fatooo/PITECH/Poster/2-IMG_20190511_161719.png

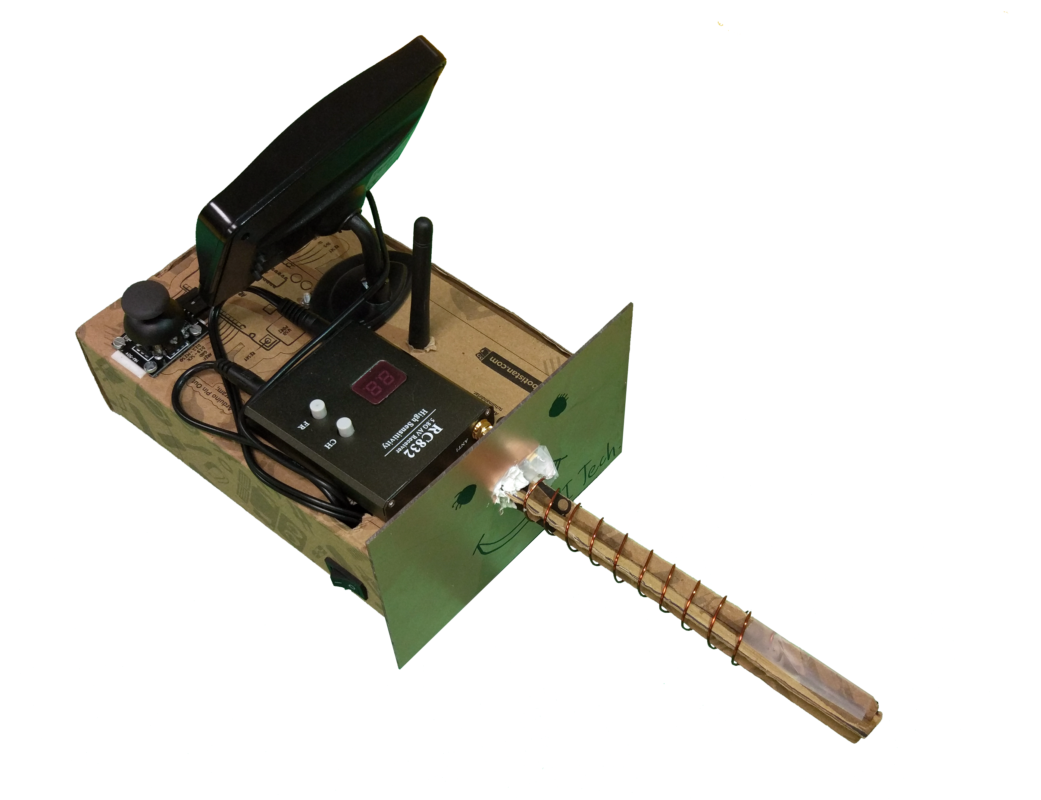
Poster/2-IMG_20190511_161719.png
