fatooo/PITECH/Weeklyler/weekly-12/Ekran Alıntısı3.PNG

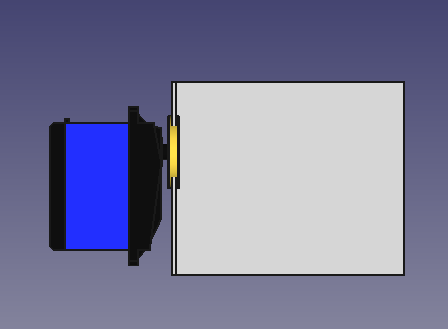
Weeklyler/weekly-12/Ekran Alıntısı3.PNG
