fatooo/PITECH/Final Report/schematic.docx

Appendix II

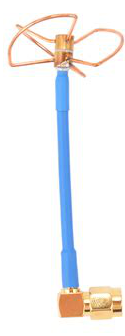
[picture p4: figure]
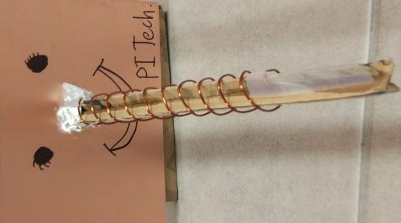
[picture p5: figure]

Overall Circuit Schematic

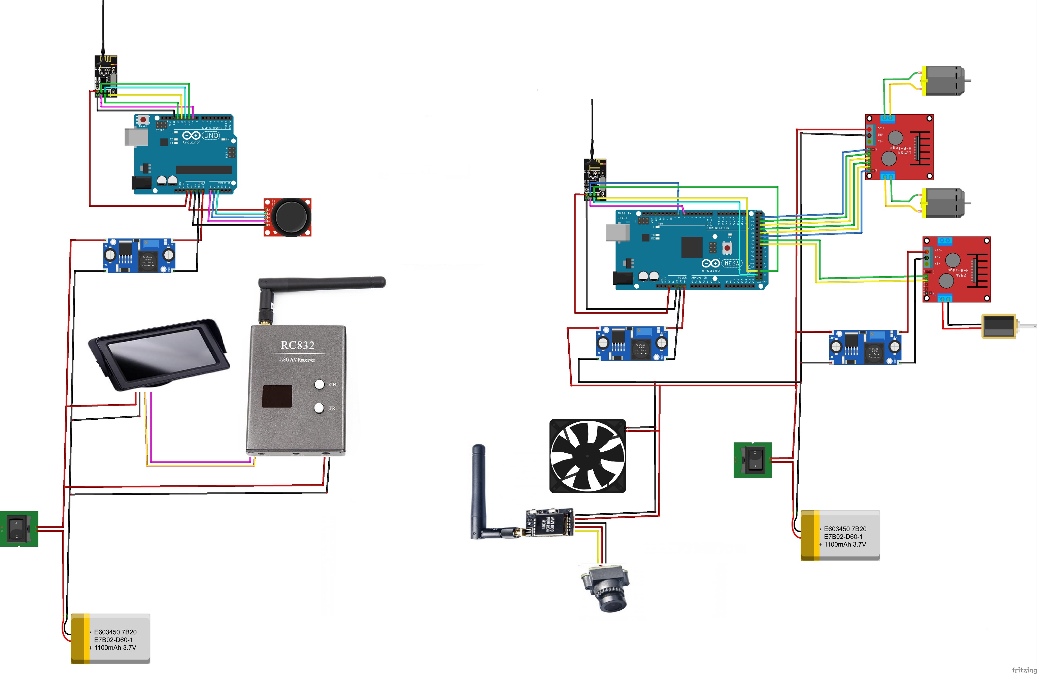
[picture p6: figure]
