fatooo/PITECH/Critical Report/headers.docx

# 1. Executive Summary

# 2. Introduction

# 3. Overall System Description

## 3.1. General Description

## 3.2. Individual Description

### 3.2.1. Power Supply Subsystem

#### 3.2.1.1. Solution Approach

#### 3.2.1.2. Block Diagram & Flowchart

### 3.2.2. Telecommunication Subsystem

#### 3.2.2.1. Solution Approach

#### 3.2.2.2. Block Diagram & Flowchart

### 3.2.3. Shooting Subsystem

#### 3.2.3.1. Solution Approach

#### 3.2.3.2. Block Diagram & Flowchart

### 3.2.4. Motion Subsystem

#### 3.2.4.1. Solution Approach

#### 3.2.4.2. Block Diagram & Flowchart

### 3.2.5. Detection Subsystem

#### 3.2.5.1. Solution Approach

#### 3.2.5.2. Block Diagram & Flowchart

## 3.3. System Level Block Diagram

## 3.4. 3D Drawings

# 4. Requirements

# 5. Design Modifications

# 6. Compatibility of the Subsystems

# 7. Test Procedures

## 7.1. Power Supply Subsystem

## 7.2. Telecommunication Subsystem

## 7.3. Shooting Subsystem

## 7.4. Motion Subsystem

## 7.5. Detection Subsystem

# 8. Compliance

# 9. Resource Management

## 9.1. Cost Estimation Breakdown

## 9.2. Power Management

## 9.3. Gantt Chart
