fatooo/PITECH/Conceptual Presentation/CONCEPTUAL_BerkayPArt.pptx

## CONCEPTUAL DESIGN PRESENTATION Devices Trying to Score in Each Others’ Goals

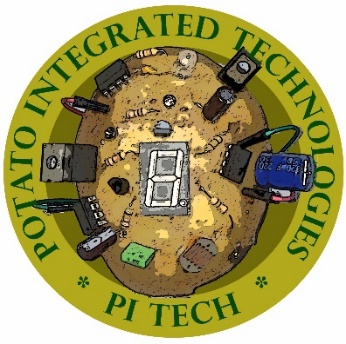
[picture p46: figure]
A close up of a clock Description generated with high confidence

PITECH

## CEO FATMA NUR ARABACI

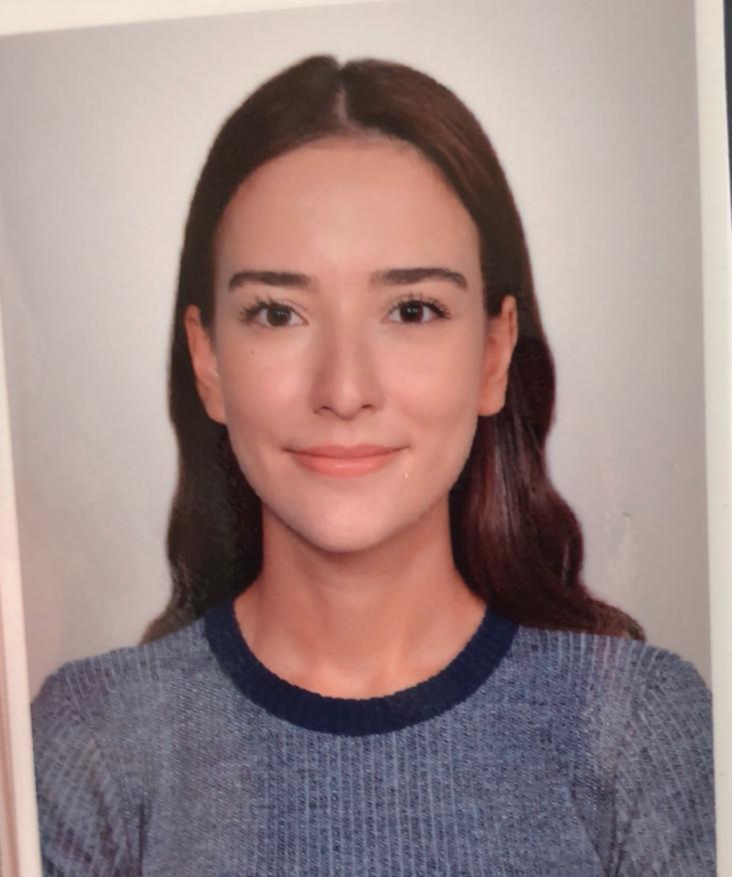
[picture p47: figure]

PITECH

## Presentation Outline

Company Profile

Problem Statement

Requirements & Objectives

01

04

Solution Approaches

Plans

02

05

03

06

Conclusion

PITECH

## COMPANY PROFILE Shareholders

- FATOOOO GELCEK

COO İrem COŞKUN 2030419 | CMO Berkay GÖKSU 2030757 | CTO Furkan Bahadır ELİK 2030518 | CEO Fatma Nur ARABACI 2030047 | CFO Aycan BEYENİR 2030328

PITECH

## Slide 5

Mission
To provide creative and reliable solutions that fulfill the needs of industry in the field of Industrial robot applications.
Vision
To become the most compelling technology company by driving the Industry’s transition to smart manufacturing.

COMPANY PROFILE
Mission & Vision

PITECH

## PROBLEM STATEMENT

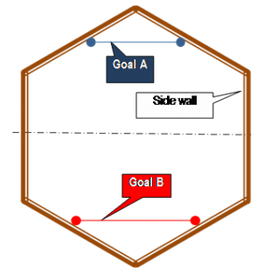
[picture p48: figure]

- Try to score in the opponents’ goal
- Try to defend our own goal
- Control via tele-controller (non-autonomous)

75 cm

PITECH

## Slide 7

Oppenents’ Goal

Opponents’ Robot

Playfield Side

The ball

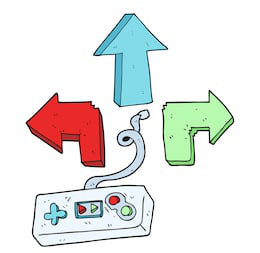
[picture p49: figure]
controller cartoon ile ilgili gÃ¶rsel sonucu

Controller Side

Half Field Line

Our Goal

> 30 m

Our Robot

PITECH

## REQUIREMENTS & OBJECTIVES Requirements & Constraints

Oppenents’ Goal

- Goal line should be two times of our robots’ diameter
- 20 sec Restriction
- Robot should stay in its’ half field
- Carrying, grasping and scooping the ball is not allowed.
- Within $200 budget

Half Field Line

Our Goal

PITECH

## REQUIREMENTS & OBJECTIVES Performance Related Objectives

Range

- Perfect–>more than 30m
- Sufficient-> 30 m indoor
- Poor/Failure-> less than 30 m

Power Consumption

- Perfect–> 30 min of operation
- Sufficient -> 15 min of operation
- Poor -> 5 min of operation

Transmission Delay

- Perfect–> 100 ms delay
- Good -> 400 ms delay
- Sufficient-> 600 ms delay
- Poor-> 1 sec delay

PITECH

## CMO BERKAY GÖKSU

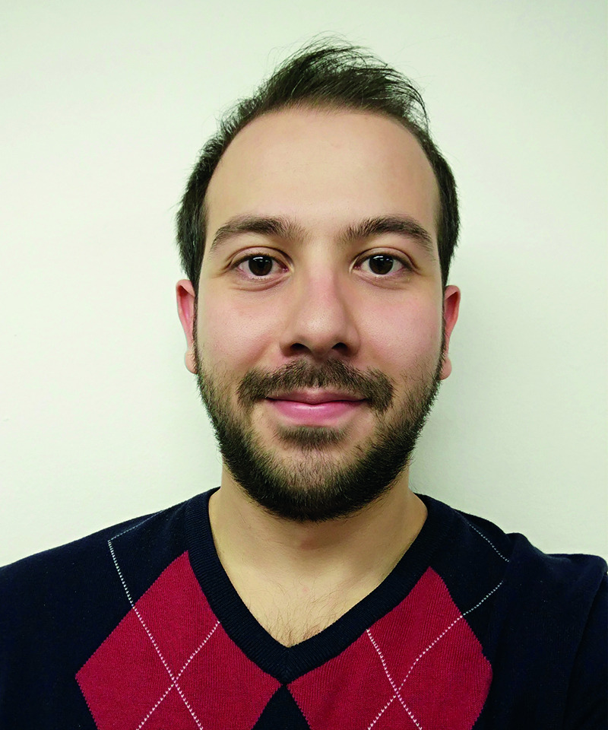
[picture p50: figure]

PITECH

## Overall Block Diagram Flow Chart Shooting Subsystem Motion Subsystem

PITECH

## Block Diagram of Robot Side

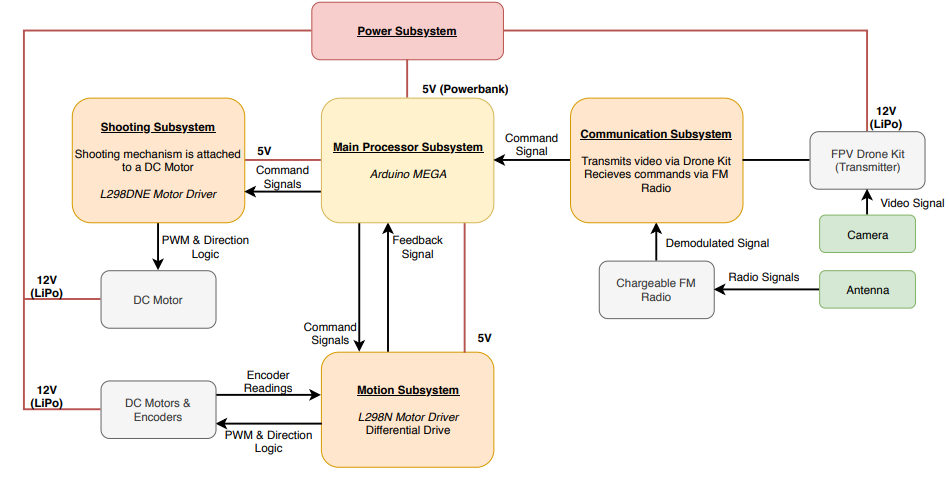
[picture p51: figure]

PITECH

## Block Diagram of Controller Side

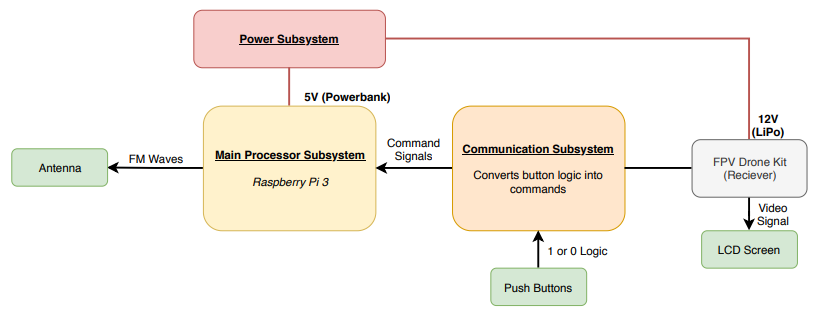
[picture p52: figure]

PITECH

## Flow Chart

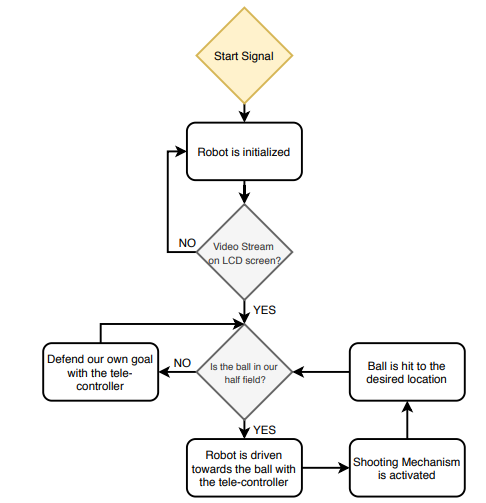
[picture p53: figure]

PITECH

## Subsystems

Shooting Subsystem
Motion Subsystem
Communication Subsystem
Power Supply Subsystem
Main Processor Subsystem

PITECH

## Shooting Subsystem

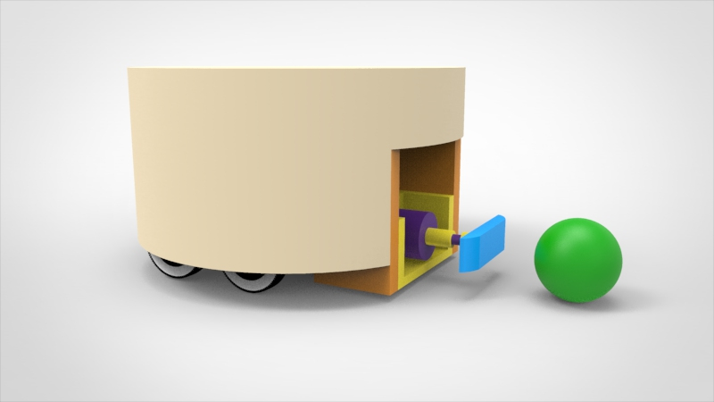
[picture p54: figure]
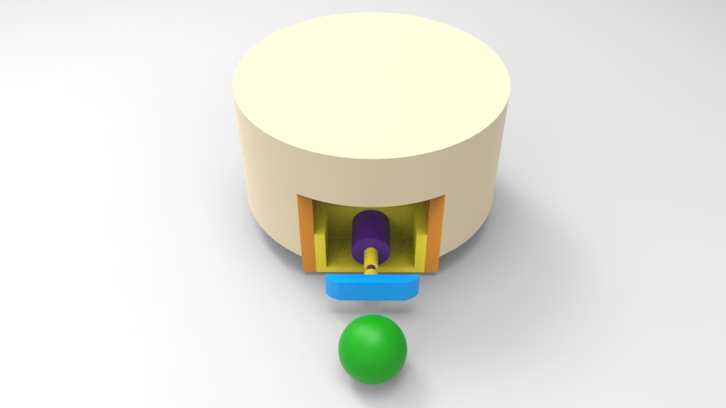
[picture p55: figure]

PITECH

## Slide 17

- Spring actuated
- Very powerful, much energy can be stored
- Simple mechanism (wound up, held, and released)

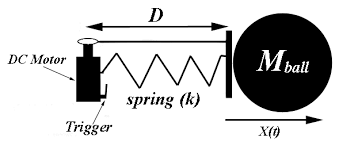
[picture p56: figure]

PITECH

## Motion Subsystem

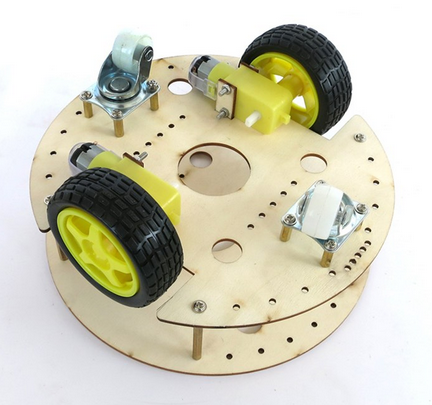
[picture p57: figure]
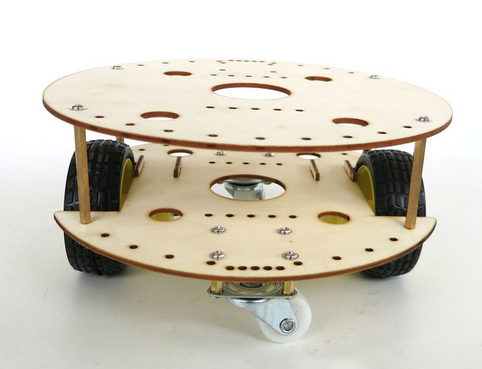
[picture p58: figure]

2 DC Motors and encoders & 2 Drive Wheels
2 Caster Wheels

PITECH

## Differential Drive

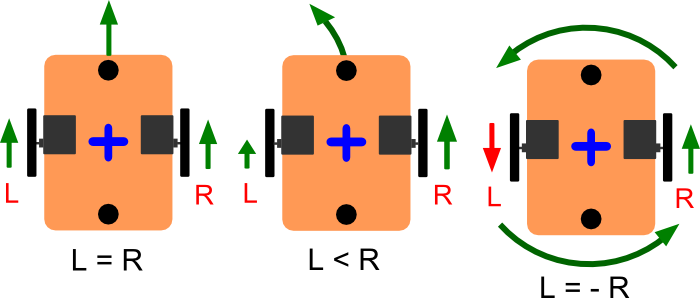
[picture p59: figure]
differential drive kinematics ile ilgili görsel sonucu

- Easy to program
- Well controlled
- Simple
- Low Cost

PITECH

## CTO FURKAN BAHADIR ELİK

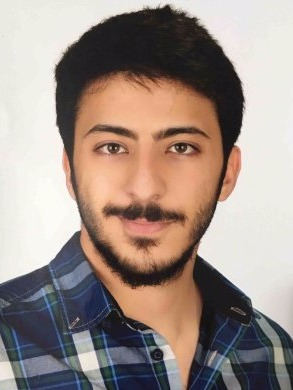
[picture p60: figure]

PITECH

## Slide 21

PITECH

## Slide 22

PITECH

## Slide 23

PITECH

## Slide 24

PITECH

## Slide 25

PITECH

## Slide 26

PITECH

## Slide 27

PITECH

## CFO AYCAN BEYENİR

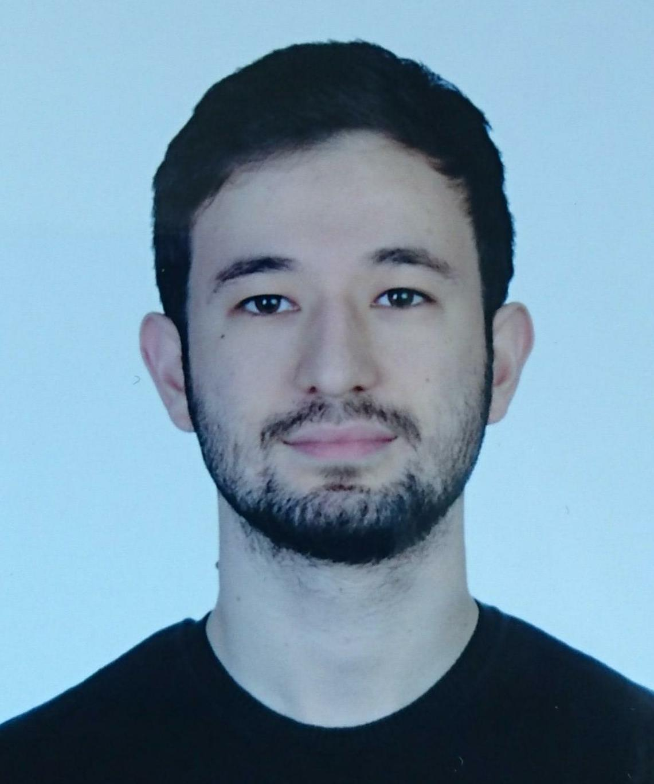
[picture p61: figure]

PITECH

## Slide 29

PITECH

## Slide 30

PITECH

## Slide 31

PITECH

## Slide 32

PITECH

## Slide 33

PITECH

## Slide 34

PITECH

## Slide 35

PITECH

## COO İREM COŞKUN

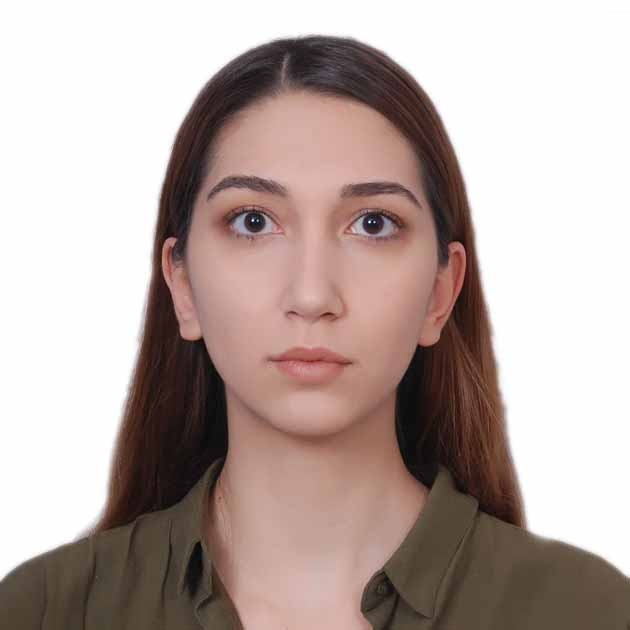
[picture p62: figure]

PITECH

## Slide 37

PITECH

## Slide 38

PITECH

## Slide 39

PITECH

## Slide 40

PITECH

## Slide 41

PITECH

## Slide 42

PITECH

## Slide 43

PITECH
