fatooo/PITECH/Conceptual Presentation/Creative-Idea-Bulb-PowerPoint-Template.pptx

- FREE
- PPT TEMPLATES

- INSERT THE TITLE
- OF YOUR PRESENTATION HERE

LogoType

http://www.free-powerpoint-templates-design.com

## Slide 2

Agenda Style

Add Contents Title

You can simply impress your audience and add a unique zing.

01

02

Add Contents Title

You can simply impress your audience and add a unique zing.

03

Add Contents Title

You can simply impress your audience and add a unique zing.

04

Add Contents Title

You can simply impress your audience and add a unique zing.

## Slide 3

- Section Break

- Insert the title of your subtitle Here

## Slide 4

- Welcome!!

- Insert the title of your subtitle Here

“

Easy to change colors, photos and Text. Get a modern PowerPoint Presentation that is beautifully designed. I hope and I believe that this Template will your Time, Money and Reputation. Easy to change colors, photos and Text. Easy to change colors, photos and Text. Get a modern PowerPoint Presentation that is beautifully designed.

“

Your Text Here

Contents

## Slide 5

- Our Services

- Insert the title of your subtitle Here

01

Your Text Here

You can simply impress your audience and add a unique zing and appeal to your Presentations.

Your Text Here

You can simply impress your audience and add a unique zing and appeal to your Presentations.

04

Your Text Here

You can simply impress your audience and add a unique zing and appeal to your Presentations.

Your Text Here

You can simply impress your audience and add a unique zing and appeal to your Presentations.

02

05

03

Your Text Here

You can simply impress your audience and add a unique zing and appeal to your Presentations.

06

Your Text Here

You can simply impress your audience and add a unique zing and appeal to your Presentations.

## Slide 6

- Our Team Layout

- Insert the title of your subtitle Here

Name Here

Programmer

You can simply impress your audience and add a unique zing.

Name Here

Programmer

You can simply impress your audience and add a unique zing.

Name Here

Programmer

You can simply impress your audience and add a unique zing.

Name Here

Programmer

You can simply impress your audience and add a unique zing.

## Slide 7

- Timeline Style

- Insert the title of your subtitle Here

You can simply impress your audience and add a unique zing and appeal to your Presentations.

2016

You can simply impress your audience and add a unique zing and appeal to your Presentations.

2018

2015

You can simply impress your audience and add a unique zing and appeal to your Presentations.

2017

You can simply impress your audience and add a unique zing and appeal to your Presentations.

2019

You can simply impress your audience and add a unique zing and appeal to your Presentations.

## Slide 8

- Infographic Style

- Insert the title of your subtitle Here

Add Contents Title

Easy to change colors, photos and Text.

Add Contents Title

Easy to change colors, photos and Text.

Add Contents Title

Add Contents Title

Easy to change colors, photos and Text.

Add Contents Title

Easy to change colors, photos and Text.

Add Contents Title

Easy to change colors, photos and Text.

Easy to change colors, photos and Text.

## Slide 9

- Infographic Style

- Insert the title of your subtitle Here

01

02

03

04

05

Add Contents Title

Your Text Here

You can simply impress your audience and add a unique zing and appeal to your Presentations.

Add Contents Title

Add Contents Title

Add Contents Title

Add Contents Title

## Slide 10

Portfolio
Presentation
Designed

Get a modern PowerPoint Presentation that is beautifully designed. Easy to change colors, photos and Text. You can simply impress your audience and add a unique zing and appeal to your Presentations. Get a modern PowerPoint Presentation that is beautifully designed. Easy to change colors, photos and Text. Get a modern PowerPoint Presentation that is beautifully designed.

## Slide 11

- Infographic Style

- Insert the title of your subtitle Here

Your Text Here

You can simply impress your audience and add a unique zing.

Your Text Here

You can simply impress your audience and add a unique zing.

Your Text Here

You can simply impress your audience and add a unique zing.

Your Text Here

You can simply impress your audience and add a unique zing.

Your Text Here

You can simply impress your audience and add a unique zing.

Your Text Here

You can simply impress your audience and add a unique zing.

Your Text Here

You can simply impress your audience and add a unique zing.

Your Text Here

You can simply impress your audience and add a unique zing.

## Slide 12

- Infographic Style

- Insert the title of your subtitle Here

You can simply impress your audience and add a unique zing and appeal to your Presentations.

Your Text Here

Your Text Here

You can simply impress your audience and add a unique zing and appeal to your Presentations.

## Slide 13

- NetBook Style

- Insert the title of your subtitle Here

Easy to change colors, photos and Text. You can simply impress your audience and add a unique zing and appeal to your Presentations. You can simply impress your audience and add a unique zing and appeal to your Presentations.
You can simply impress your audience and add a unique zing and appeal to your Presentations.

Text Here

You can simply impress your audience and add a unique zing and appeal to your Presentations. Easy to change colors, photos and Text.

## Slide 14

- Infographic Style

- Insert the title of your subtitle Here

Your Text Here

You can simply impress your audience and add a unique zing and appeal to your Presentations.

Your Text Here

You can simply impress your audience and add a unique zing and appeal to your Presentations.

Your Text Here

You can simply impress your audience and add a unique zing and appeal to your Presentations.

Your Text Here

You can simply impress your audience and add a unique zing and appeal to your Presentations.

Your Text Here

You can simply impress your audience and add a unique zing and appeal to your Presentations.

## Slide 15

- Portfolio Presentation

- Insert the title of your subtitle Here

Simple Portfolio Designed

Get a modern PowerPoint Presentation that is beautifully designed. Easy to change colors, photos and Text. You can simply impress your audience and add a unique zing and appeal to your Presentations. Get a modern PowerPoint Presentation that is beautifully designed. Easy to change colors, photos and Text. Get a modern PowerPoint Presentation that is beautifully designed.

## Slide 16

- Infographic Style

- Insert the title of your subtitle Here

Your Text Here

You can simply impress your audience and add a unique zing and appeal to your Presentations.

Your Text Here

You can simply impress your audience and add a unique zing and appeal to your Presentations.

A

B

D

C

Your Text Here

You can simply impress your audience and add a unique zing and appeal to your Presentations.

Your Text Here

You can simply impress your audience and add a unique zing and appeal to your Presentations.

## Slide 17

Your Text Here

Simple Portfolio
Designed

Get a modern PowerPoint Presentation that is beautifully designed. Easy to change colors, photos and Text. You can simply impress your audience and add a unique zing and appeal to your Presentations. Get a modern PowerPoint Presentation that is beautifully designed. Easy to change colors, photos and Text. Get a modern PowerPoint Presentation that is beautifully designed.

Your Text Here

Your Text Here

Your Text Here

## Slide 18

- Chart Style

- Insert the title of your subtitle Here

80%

Add Contents Title

You can simply impress your audience and add a unique zing.

80%

50%

You can simply impress your audience and add a unique zing and appeal to your Presentations. Get a modern PowerPoint Presentation that is beautifully designed. You can simply impress your audience and add a unique zing and appeal to your Presentations. Get a modern PowerPoint Presentation that is beautifully designed.
Get a modern PowerPoint Presentation that is beautifully designed. Easy to change colors, photos and Text.

40%

70%

60%

## Slide 19

PowerPoint Presentation

- Worldmap Style

You can simply impress your audience and add a unique zing and appeal to your Presentations. Easy to change colors, photos and Text. Easy to change colors, photos and Text. Get a modern PowerPoint Presentation that is beautifully designed. Easy to change colors, photos and Text.
Get a modern PowerPoint Presentation that is beautifully designed. You can simply impress your audience and add a unique zing and appeal to your Presentations. Easy to change colors, photos and Text.

## Slide 20

Portfolio Designed

You can simply impress your audience and add a unique zing and appeal to your Presentations.

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

Portfolio
Presentation
Designed

## Slide 21

- Infographic Style

- Insert the title of your subtitle Here

Your Text Here

Easy to change colors, photos and Text.

Infographic Designed

Easy to change colors, photos and Text.

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

Your Text Here

Easy to change colors, photos and Text.

Your Text Here

Easy to change colors, photos and Text.

Your Text Here

Easy to change colors, photos and Text.

## Slide 22

- Table Style

- Insert the title of your subtitle Here

Your Text Here
$52
| Text Here
| You can simply impress your audience and add a unique zing.
Your Text Here

Your Text Here
$80
| Text Here
| You can simply impress your audience and add a unique zing.
Your Text Here

Your Text Here
$75
| Text Here
| You can simply impress your audience and add a unique zing.
Your Text Here

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

## Slide 23

- Mobile Style

- Insert the title of your subtitle Here

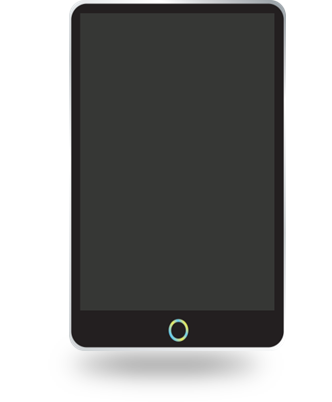
[picture p101: figure]

Simple Portfolio Designed

Your Text Here

You can simply impress your audience and add a unique zing and appeal to your Presentations.

Your Text Here

You can simply impress your audience and add a unique zing and appeal to your Presentations.

Your Text Here

You can simply impress your audience and add a unique zing and appeal to your Presentations.

Your Text Here

Easy to change colors, photos and Text.

Your Text Here

Easy to change colors, photos and Text.

Your Text Here

Easy to change colors, photos and Text.

## Slide 24

- Chart Style

- Insert the title of your subtitle Here

40%

Your Text Here

Get a modern PowerPoint Presentation that is beautifully designed.

Your Text Here

Get a modern PowerPoint Presentation that is beautifully designed.

35%

## Slide 25

- Portfolio Presentation

- Insert the title of your subtitle Here

You can simply impress your audience and add a unique zing and appeal to your Presentations. Easy to change colors, photos and Text.

## Slide 26

- Infographic Style

- Insert the title of your subtitle Here

01

Your Text Here

You can simply impress your audience and add a unique zing and appeal to your Presentations.

Your Text Here

You can simply impress your audience and add a unique zing and appeal to your Presentations.

Your Text Here

You can simply impress your audience and add a unique zing and appeal to your Presentations.

Your Text Here

You can simply impress your audience and add a unique zing and appeal to your Presentations.

02

03

04

## Slide 27

- Chart Style

- Insert the title of your subtitle Here

Your Text Here

You can simply impress your audience and add a unique zing and appeal to your Presentations.

Your Text Here

You can simply impress your audience and add a unique zing and appeal to your Presentations.

Your Text Here

You can simply impress your audience and add a unique zing and appeal to your Presentations.

50%

70%

30%

## Slide 28

- Worldmap Style

- Insert the title of your subtitle Here

Your Text Here

Simple PowerPoint
Presentation Designed

Get a modern PowerPoint Presentation that is beautifully designed. You can simply impress your audience and add a unique zing and appeal to your Presentations.

Text Here

You can simply impress your audience and add a unique zing.

Text Here

You can simply impress your audience and add a unique zing.

Text Here

You can simply impress your audience and add a unique zing.

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

## Slide 29

Portfolio
Presentation
Designed

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

## Slide 30

- Table Style

- Insert the title of your subtitle Here

PowerPoint Presentation

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

Your Text Here

| $150
| Content Here
| Text Here
| Text Here
| Text Here
| Text Here
| Text Here
Content Here

| $180
| Content Here
| Text Here
| Text Here
| Text Here
| Text Here
| Text Here
Content Here

| $160
| Content Here
| Text Here
| Text Here
| Text Here
| Text Here
| Text Here
Content Here

## Slide 31

Your Text Here

You can simply impress your audience and add a unique zing and appeal to your Presentations. Easy to change colors, photos and Text.
You can simply impress your audience and add a unique zing and appeal to your Presentations. You can simply impress your audience and add a unique zing and appeal to your Presentations. Easy to change colors, photos and Text. You can simply impress your audience and add a unique zing and appeal to your Presentations. You can simply impress your audience and add a unique zing and appeal to your Presentations. Easy to change colors, photos and Text. You can simply impress your audience and add a unique zing and appeal to your Presentations.
You can simply impress your audience and add a unique zing and appeal to your Presentations.
Easy to change colors, photos and Text. You can simply impress your audience and add a unique zing and appeal to your Presentations. You can simply impress your audience and add a unique zing and appeal to your Presentations.

One Columns Designed

## Slide 32

Two Columns Designed

Your Text Here

You can simply impress your audience and add a unique zing and appeal to your Presentations. Easy to change colors, photos and Text.
You can simply impress your audience and add a unique zing and appeal to your Presentations. You can simply impress your audience and add a unique zing and appeal to your Presentations. Easy to change colors, photos and Text. You can simply impress your audience and add a unique zing and appeal to your Presentations.
You can simply impress your audience and add a unique zing and appeal to your Presentations.

Your Text Here

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

## Slide 33

- Thank you

- Insert the title of your subtitle Here

## Slide 34

- Fully Editable Shapes

## Slide 35

- Fully Editable Icon Sets : A

You can Resize without losing quality

You can Change Fill Color &
Line Color

FREE
PPT TEMPLATES

www.allppt.com

## Slide 36

- Fully Editable Icon Sets : B

You can Resize without losing quality

You can Change Fill Color &
Line Color

FREE
PPT TEMPLATES

www.allppt.com

## Slide 37

- Fully Editable Icon Sets : C

You can Resize without losing quality

You can Change Fill Color &
Line Color

FREE
PPT TEMPLATES

www.allppt.com
