fatooo/PITECH/Weeklyler/Weekly 16.docx

20.03.2019-26.03.2019

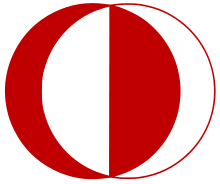
[picture p103: figure]
Image result for METU

MIDDLE EAST TECHNICAL UNIVERSITY

DEPARTMENT OF ELECTRICAL AND ELECTRONICS ENGINEERING

EE493 – Weekly Progress Report #16

POTATO INTEGRATED TECHNOLOGIES

A close up of a clock Description generated with high confidence

Design Studio Coordinator: Arzu KOÇ

Partners and Contact Information:

Fatma Nur ARABACI 2030047 0533 602 75 27 arabaci.fn@gmail.com

İrem COŞKUN 2030419 0539 414 59 69 iremcoskun0@gmail.com

Aycan BEYENİR 2030328 0539 330 05 70 abeyenir@gmail.com

Berkay GÖKSU 2030757 0505 635 81 45 berkaygoksu1@gmail.com

Furkan Bahadır ELİK 2030518 0554 963 94 10 elik.bahadir@metu.edu.tr

What has been done:

In this week we implemented our range test for the command system after receiving the delivery of the antenna. Even though we conducted the same test in design laboratory we couldn’t have obtained the desired outcomes. However, with this new antenna we managed to control our robot from the top floor of E-block when the robot is placed close to the canteen in D-block. We are planning to conduct the same test by connecting a bypass capacitor between the Vcc and GND pins of the transmitter side Arduino. We are expecting to see improved performance even though this current range is enough for the command part.

We also optimized our motor code so that it can achieve smooth start and brake. We also tuned it’s speed by considering the sizes of the playfield. Later touchups can be made in the future regarding our final product.

Furthermore, we also bought spacers for the physical structure of our robots’ chassis, step-up & down regulators, and 3s LiPo battery with 1350 mAh capacity to drive the DC motors. This one has a greater capacity so that we do not need to charge the batteries that often.

Next week’s plan:

- Second layer of the robot will be integrated with the first layer using the spacers
- Regulator tests will be done.
- Shooting subsystem will be tested with step-up regulator.
