fatooo/PITECH/Weeklyler/Weekly-10/Week-10.docx

13.12.2018-20.12.2018

Image result for METU

MIDDLE EAST TECHNICAL UNIVERSITY

DEPARTMENT OF ELECTRICAL AND ELECTRONICS ENGINEERING

EE493 – Weekly Progress Report #10

POTATO INTEGRATED TECHNOLOGIES

A close up of a clock Description generated with high confidence

Design Studio Coordinator: Arzu KOÇ

Partners and Contact Information:

Fatma Nur ARABACI 2030047 0533 602 75 27 arabaci.fn@gmail.com

İrem COŞKUN 2030419 0539 414 59 69 iremcoskun0@gmail.com

Aycan BEYENİR 2030328 0539 330 05 70 abeyenir@gmail.com

Berkay GÖKSU 2030757 0505 635 81 45 berkaygoksu1@gmail.com

Furkan Bahadır ELİK 2030518 0554 963 94 10 elik.bahadir@metu.edu.tr

What has been done:

In this week we put our full concentration on the preparations for demo. We worked mostly on optimizations of the subsystems. This week also we decided that out plans is going to be drone kit from now on for video transmission (detection subsystem).New test procedure has been written for new method and updated version submitted. Also, some visual improvements made for demonstration. Moreover, new equipment bought from Konya Sokak.

Optimization of the Command Transmission:

To improve the command transmission we changed our antenna. LED and button instalments made to different boxes. Final connections for demonstration made. Now, we have a fully functional system which blinks the LED when same colored button pressed. We worked on amplifier circuit. Amplifier circuit designs made but during the experiments it did not show as planned due to the reason that our transistor cannot drive high frequencies

Video Transmission:

We received our shipments for video transmission. We tried the systems and have better results than our image processing system so we decided to move with that for now on. Actually this was always a plan for us but since we haven’t received our shipments we did not have time to work on that. We worked on image processing because we have not received our shipment. We bought li-po battery for video transmitter and camera system. 3s li-po with 900 mAh selected. Also for, receiving video we bought screen to watch the video at the same time. Another li-po is also needed for video receiver but since we have not decided how to drive our motors we will work with power supply for demonstration.

Next week’s plan:

Next week we are planning to work on conceptual design and presentation. All the solutions for subsystems and whole module will be decided. Detailed time plan, solutions and test procedures will be argued. A weekly meeting will be held in company headquarters.
