fatooo/PITECH/raspberrypidenemeleri/image_process/image_process_detect_ball_Python.docx

import RPi.GPIO as GPIO

GPIO.setmode(GPIO.BOARD)

GPIO.setup(37, GPIO.OUT)

GPIO.setup(35, GPIO.OUT) # GPIO INITIALIZATION

GPIO.setup(33, GPIO.OUT)

GPIO.setup(29, GPIO.OUT)

GPIO.setup(31, GPIO.OUT)

GPIO.setup(38, GPIO.OUT)

GPIO.setup(40, GPIO.OUT)

GPIO.setup(7, GPIO.IN)

import math

center_read=325

center_read_green=320

# import the necessary packages

from picamera.array import PiRGBArray # CAMERA INITIALIZATION

from picamera import PiCamera

import time

import cv2

import numpy as np

# initialize the camera and grab a reference to the raw camera capture

camera = PiCamera()

camera.resolution = (640, 480)

camera.framerate = 50

camera.hflip = True

rawCapture = PiRGBArray(camera, size=(640, 480))

# allow the camera to warmup

time.sleep(0.1)

def find_red_center():

# capture frames from the camera

for frame in camera.capture_continuous(rawCapture, format="bgr", use_video_port=True):

# grab the raw NumPy array representing the image, then initialize the timestamp

# and occupied/unoccupied text

image = frame.array

blur = cv2.blur(image, (3,3))

#hsv to complicate things, or stick with BGR

hsv = cv2.cvtColor(blur,cv2.COLOR_BGR2HSV)

#thresh = cv2.inRange(hsv,np.array((0, 200, 200)), np.array((20, 255, 255)))

lower = np.array([167,184,86],dtype="uint8")

#upper = np.array([225,88,50], dtype="uint8")

upper = np.array([179,255,255], dtype="uint8")

thresh = cv2.inRange(hsv, lower, upper)

thresh2 = thresh.copy()

# find contours in the threshold image

contours,hierarchy = cv2.findContours(thresh,cv2.RETR_LIST,cv2.CHAIN_APPROX_SIMPLE)

# finding contour with maximum area and store it as best_cnt

max_area = int(100)

best_cnt = 1

cx_most_left = int(0)

new_area = 1

cx_search,cy_search = [0,0]

for cnt in contours:

area = int(cv2.contourArea(cnt))

M_search = cv2.moments(cnt)

if not(M_search['m00']== 0):

cx_search,cy_search = int(M_search['m10']/M_search['m00']), int(M_search['m01']/M_search['m00'])

if ((area > max_area) & (cx_search > cx_most_left)):

best_cnt = cnt

new_area = area

cx_most_left = cx_search

# finding centroids of best_cnt and draw a circle there

M = cv2.moments(best_cnt)

#new_area = cv2.contourArea(best_cnt)

r = math.sqrt(new_area/3.1415)

r=int(math.ceil(r))

cx,cy = int(M['m10']/M['m00']), int(M['m01']/M['m00'])

#if best_cnt>1:

cv2.circle(blur,(cx,cy),10,(0,0,255),-1)

cv2.circle(blur,(cx,cy),r,(0,255,0),5)

# show the frame

cv2.imshow("Frame", blur)

#cv2.imshow('thresh',thresh2)

key = cv2.waitKey(1) & 0xFF

# clear the stream in preparation for the next frame

rawCapture.truncate(0)

#print the center coordinates

print(cx,cy)

# if the `q` key was pressed, break from the loop

if key == ord("q"):

break

return cx

def find_green_center():

# capture frames from the camera

for frame in camera.capture_continuous(rawCapture, format="bgr", use_video_port=True):

# grab the raw NumPy array representing the image, then initialize the timestamp

# and occupied/unoccupied text

image = frame.array

blur = cv2.blur(image, (3,3))

#hsv to complicate things, or stick with BGR

hsv = cv2.cvtColor(blur,cv2.COLOR_BGR2HSV)

#thresh = cv2.inRange(hsv,np.array((0, 200, 200)), np.array((20, 255, 255)))

lower = np.array([35,91,10],dtype="uint8")

#upper = np.array([225,88,50], dtype="uint8")

upper = np.array([80,255,255], dtype="uint8")

thresh = cv2.inRange(hsv, lower, upper)

thresh2 = thresh.copy()

# find contours in the threshold image

contours,hierarchy = cv2.findContours(thresh,cv2.RETR_LIST,cv2.CHAIN_APPROX_SIMPLE)

# finding contour with maximum area and store it as best_cnt

max_area = 100

best_cnt = 1

for cnt in contours:

area = cv2.contourArea(cnt)

if area > max_area:

best_cnt = cnt

max_area = area

# finding centroids of best_cnt and draw a circle there

M = cv2.moments(best_cnt)

r = math.sqrt(max_area/3.1415)

r=int(math.ceil(r))

cx,cy = int(M['m10']/M['m00']), int(M['m01']/M['m00'])

#if best_cnt>1:

cv2.circle(blur,(cx,cy),10,(0,0,255),-1)

cv2.circle(blur,(cx,cy),r,(0,255,0),5)

# show the frame

cv2.imshow("Frame", blur)

#cv2.imshow('thresh',thresh2)

key = cv2.waitKey(1) & 0xFF

# clear the stream in preparation for the next frame

rawCapture.truncate(0)

#print the center coordinates

print(cx,cy)

# if the `q` key was pressed, break from the loop

if key == ord("q"):

break

return cx

def asagi_in():

GPIO.output(29, 1) # topu bırak

GPIO.output(31, 1) # topu al

GPIO.output(38, 0) # aşağı

GPIO.output(40, 1) # yukarı

GPIO.output(29, 1) # topu bırak

GPIO.output(31, 1) # topu al

GPIO.output(38, 1) # aşağı

GPIO.output(40, 1) # yukarı

def yukari_cik():

GPIO.output(29, 1) # topu bırak

GPIO.output(31, 1) # topu al

GPIO.output(38, 1) # aşağı

GPIO.output(40, 0) # yukarı

GPIO.output(29, 1) # topu bırak

GPIO.output(31, 1) # topu al

GPIO.output(38, 1) # aşağı

GPIO.output(40, 1) # yukarı

def topu_birak():

GPIO.output(29, 0) # topu bırak

GPIO.output(31, 1) # topu al

GPIO.output(38, 1) # aşağı

GPIO.output(40, 1) # yukarı

GPIO.output(29, 1) # topu bırak

GPIO.output(31, 1) # topu al

GPIO.output(38, 1) # aşağı

GPIO.output(40, 1) # yukarı

def topu_al():

GPIO.output(29, 1) # topu bırak

GPIO.output(31, 0) # topu al

GPIO.output(38, 1) # aşağı

GPIO.output(40, 1) # yukarı

GPIO.output(29, 1) # topu bırak

GPIO.output(31, 1) # topu al

GPIO.output(38, 1) # aşağı

GPIO.output(40, 1) # yukarı

def stop():

GPIO.output(37, 0)

GPIO.output(35, 0)

GPIO.output(33, 0)

def forward():

GPIO.output(37, 1)

GPIO.output(35, 1)

GPIO.output(33, 1)

def right():

GPIO.output(37, 0)

GPIO.output(35, 0)

GPIO.output(33, 1)

def left():

GPIO.output(37, 1)

GPIO.output(35, 0)

GPIO.output(33, 0)

def backward():

GPIO.output(37, 0)

GPIO.output(35, 1)

GPIO.output(33, 1)

def cwsearch():

GPIO.output(37, 1)

GPIO.output(35, 1)

GPIO.output(33, 0)

top_bende = 0

flag=0 #initial search flagi

flag_basket=0 #initial search flagi basket

while(1):

if top_bende == 0:

center_x_ball = find_red_center()

left_margin=center_read-1

right_margin=center_read+1

if flag==0:

cwsearch()

time.sleep(2.2)

stop()

while(not(center_read-100<center_x_ball <center_read+100)): #initial search

cwsearch()

time.sleep(0.7)

stop()

center_x_ball = find_red_center()

if center_read-100<center_x_ball <center_read+100:

flag=1

break

if left_margin< center_x_ball < right_margin:

forward()

elif center_x_ball == 0 :

cwsearch()

print("turning around")

elif center_x_ball < left_margin:

print("going right")

right()

time.sleep(0.05)

elif right_margin < center_x_ball:

print("going left")

left()

time.sleep(0.05)

else :

stop()

if (GPIO.input(7)==0): #top gördüm mü

stop()

time.sleep(0.2)

if(GPIO.input(7)==0): #kesin gördüm

top_bende = 1

asagi_in()

backward()

time.sleep(1)

stop()

time.sleep(16)

forward()

time.sleep(2)

stop()

yukari_cik() #topu aldımmmmm

time.sleep(5)

backward()

time.sleep(3)

stop()

print "top bende"

cwsearch()

time.sleep(2.2)

stop()

if top_bende == 1:

print "simdi basketi ariyorum"

center_basket = find_green_center()

left_margin_green=center_read_green-1

right_margin_green=center_read_green+1

if flag_basket==0:

while(not(center_read_green-100<center_basket< center_read_green+100)): #initial search

cwsearch()

time.sleep(0.7)

stop()

center_basket = find_green_center()

if center_read_green-150<center_basket< center_read_green+150:

flag_basket=1

break

if left_margin_green< center_basket < right_margin_green:

forward()

elif center_basket == 0 :

cwsearch()

print("turning around basketi ariyorum")

elif center_basket < left_margin_green:

print("going right")

right()

time.sleep(0.05)

elif right_margin_green < center_basket:

print("going left")

left()

time.sleep(0.05)

else :

stop()

if (GPIO.input(7)==0): #gordum mu

stop()

time.sleep(0.2)

if(GPIO.input(7)==0): #kesin gordum

print("basketi gördüm")

stop()

forward()

time.sleep(0.4)

stop()

topu_birak()

time.sleep(1)

backward()

time.sleep(2.5)

stop()

time.sleep(1)

topu_al()

time.sleep(2)

print "topu biraktim"

flag_basket=0 #initialize all flags

top_bende=0

flag=0
