fatooo/PITECH/Weeklyler/Weekly-9/baho_week9.docx

On optimization issues on transmission delay of commands due to transmitter program running on Raspberry Pi, we worked on solving the delay problem. We had about 1 secons of delay before which was unacceptable for the project. To solve the issue, first we debugged the program and find whşch part is causing such a delay. It was important to determine that the bottleneck is whether our code or the Raspberry Pi’s proccessor speed. Because if it was the Rpi’s speed, we would have a serious problem. However, luckly, we were able to identify the problem and solve it. The problem was a non-optimized piece of the algorithm that we were implemented. After making the necessary changes, now, we are able to send the commands at instant. We tested the new code and saw that the LEDs blink at the instant we press the buttons.
