fatooo/PITECH/Weeklyler/Weekly-5/KKM_foto/turuncu.JPG

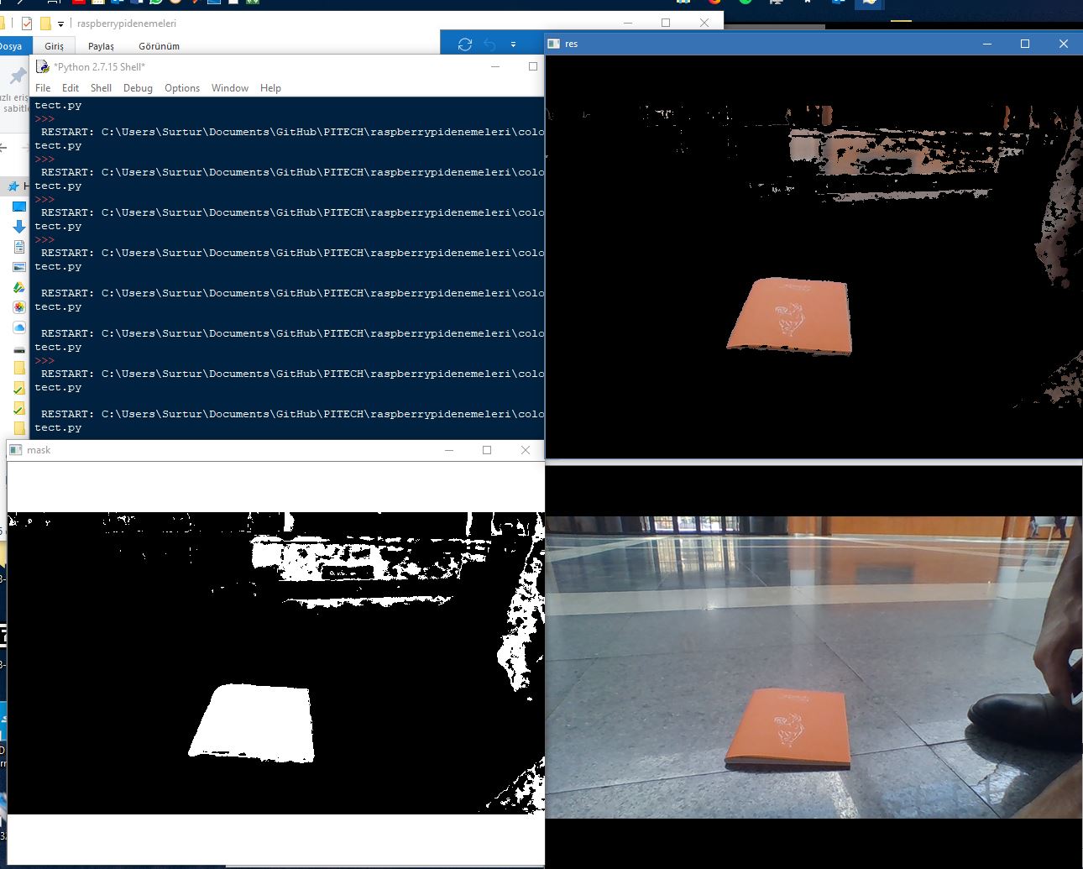
Weeklyler/Weekly-5/KKM_foto/turuncu.JPG
