fatooo/PITECH/Weeklyler/Weekly-5/KKM_foto/turuncu_isik.JPG

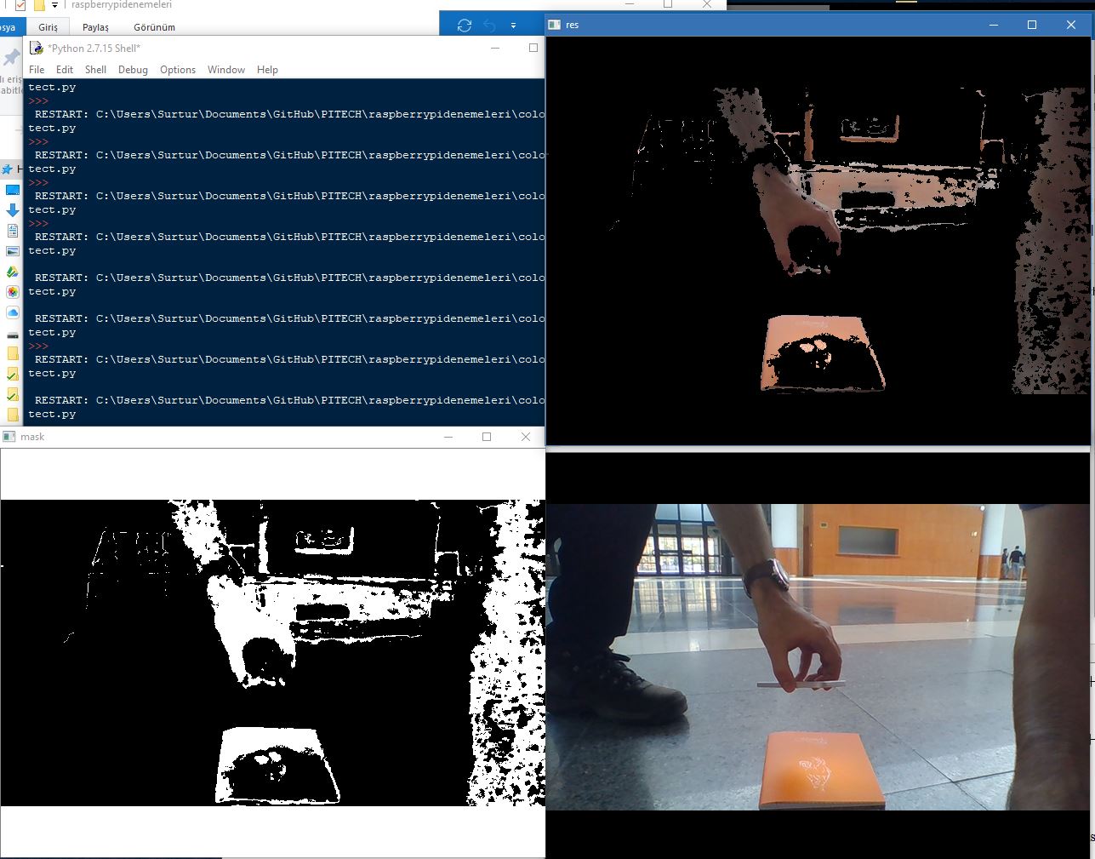
Weeklyler/Weekly-5/KKM_foto/turuncu_isik.JPG
