fatooo/PITECH/Weeklyler/Weekly-5/KKM_foto/zemin0-30.JPG

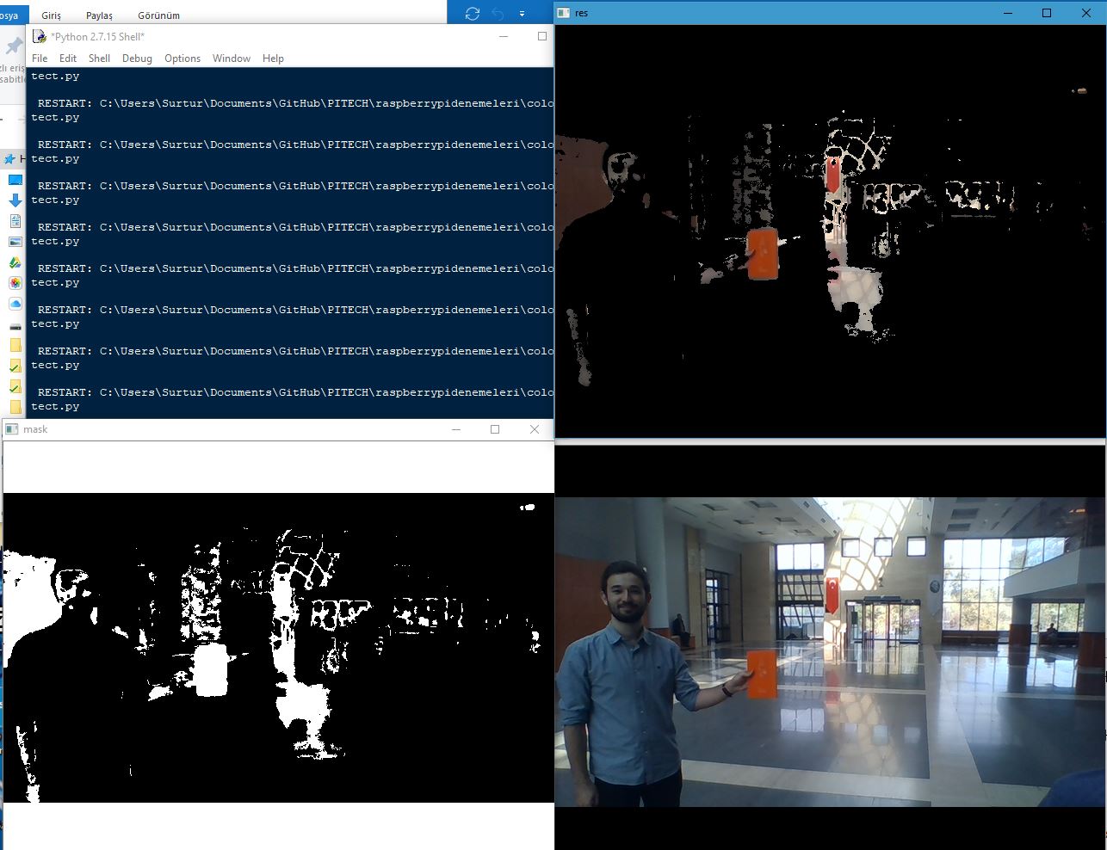
Weeklyler/Weekly-5/KKM_foto/zemin0-30.JPG
