fatooo/PITECH/Weeklyler/Weekly-5/KKM_foto/zemin3.JPG

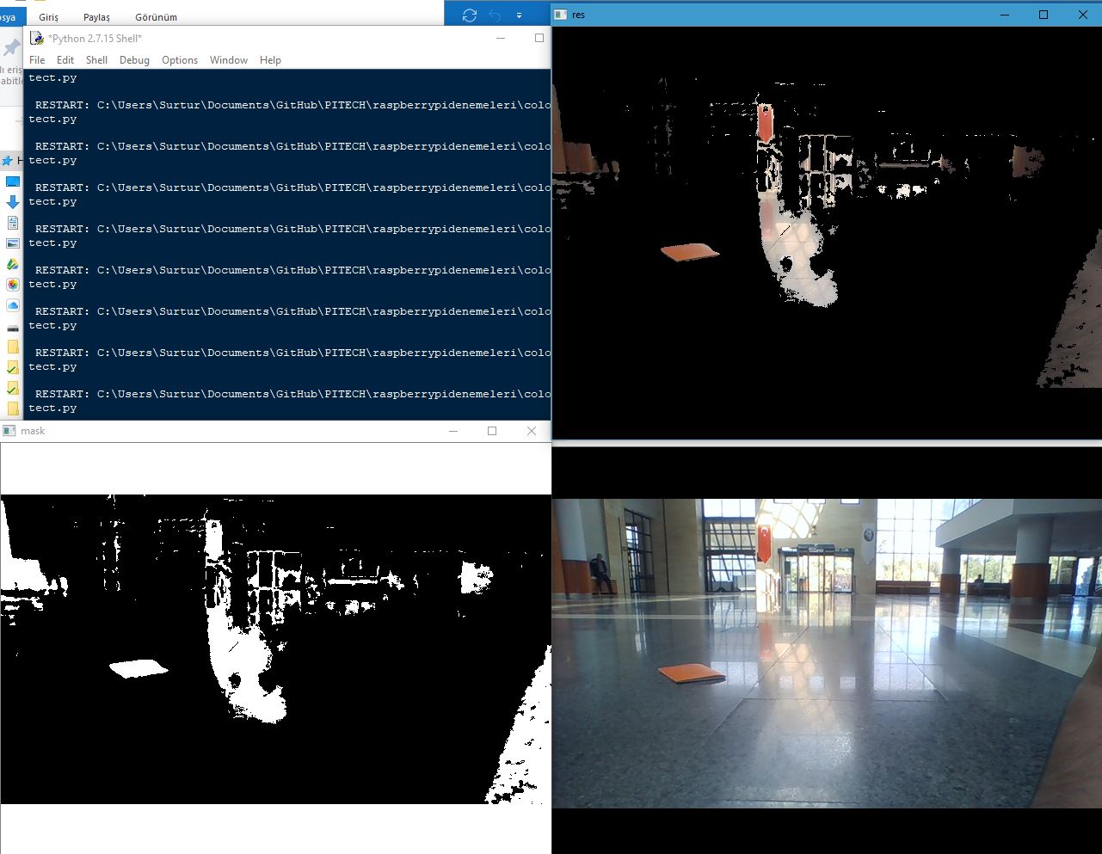
Weeklyler/Weekly-5/KKM_foto/zemin3.JPG
