fatooo/PITECH/Weeklyler/Weekly-5/KKM_foto/zemin.JPG

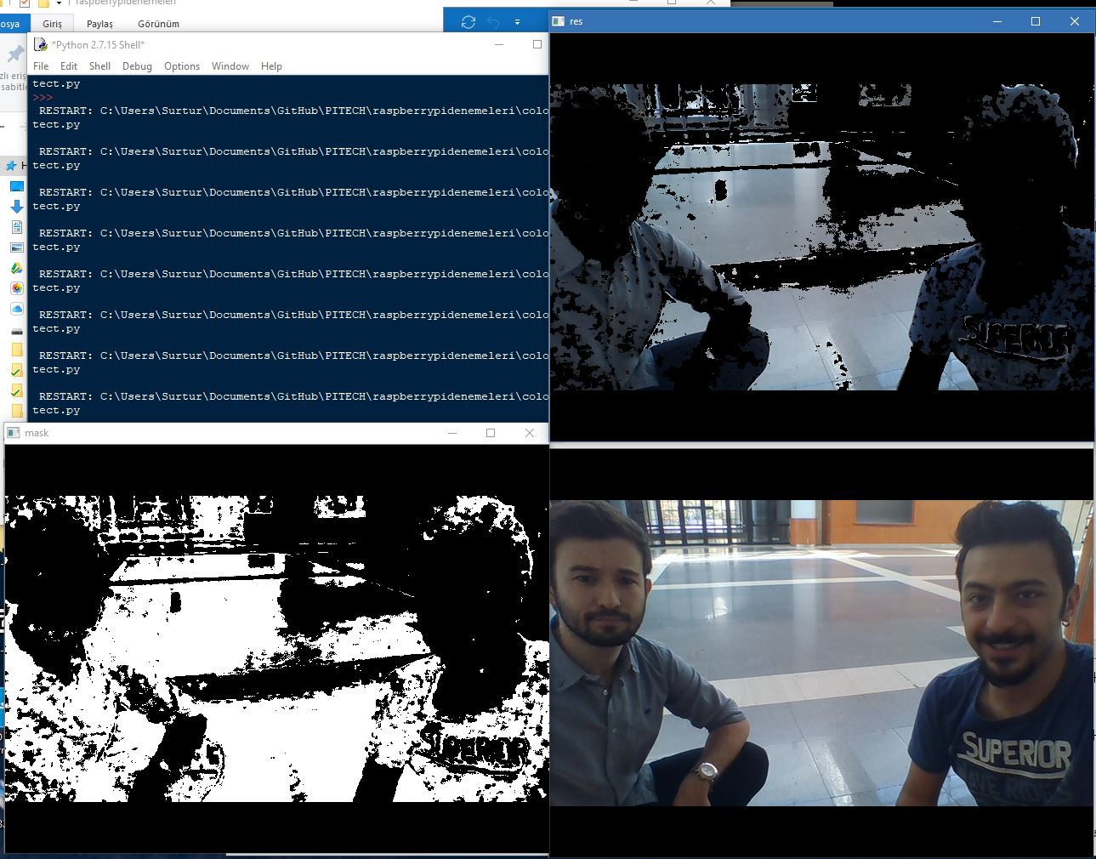
Weeklyler/Weekly-5/KKM_foto/zemin.JPG
