fatooo/PITECH/Weeklyler/Weekly-5/KKM_foto/zemin_green_40_90.JPG

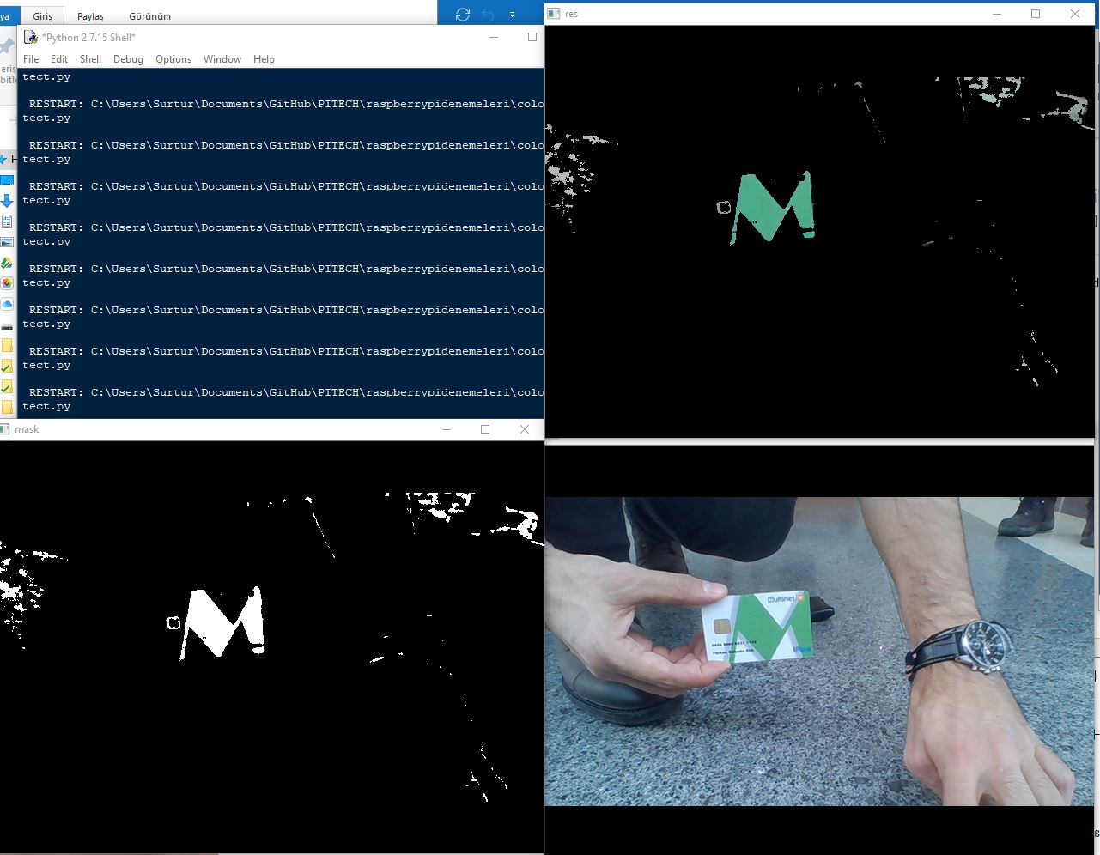
Weeklyler/Weekly-5/KKM_foto/zemin_green_40_90.JPG
