fatooo/PITECH/Weeklyler/Weekly-11/WhatsApp Image 2019-02-19 at 18.53.34.jpeg

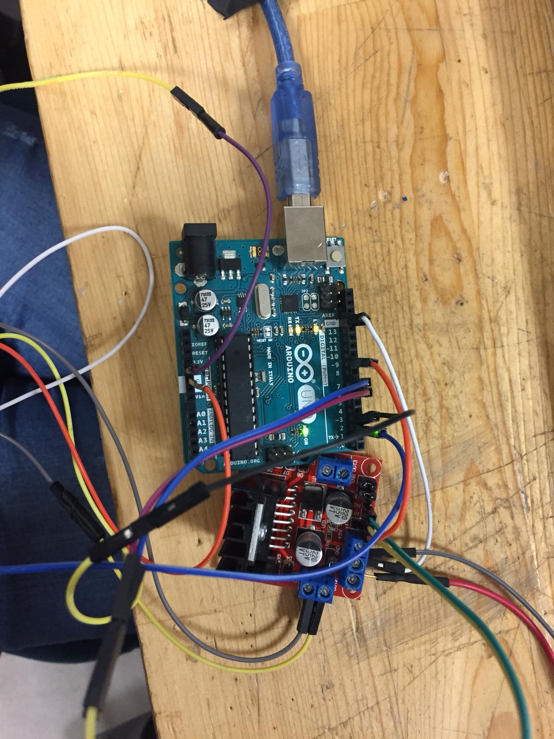
Weeklyler/Weekly-11/WhatsApp Image 2019-02-19 at 18.53.34.jpeg
