fatooo/PITECH/Weeklyler/weekly-12/Ekran Alıntısı2.PNG

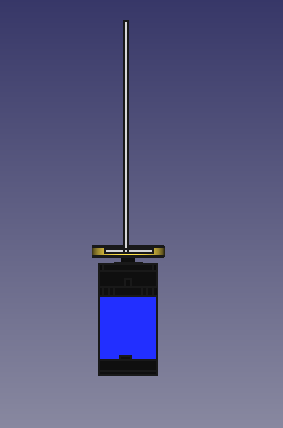
Weeklyler/weekly-12/Ekran Alıntısı2.PNG
