fatooo/PITECH/Çizim falan/camera_mount.FCStd

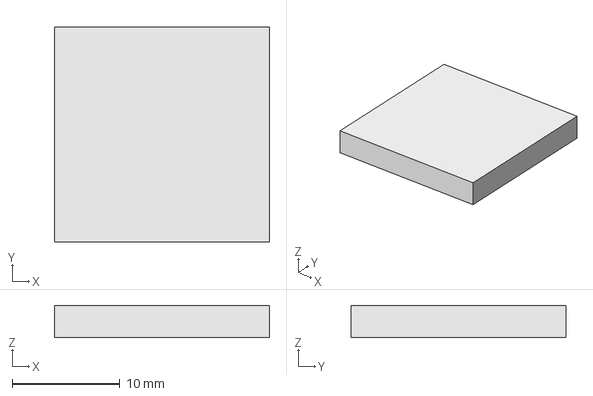
[picture p241: CAD file, 2019-04-07]
Çizim falan/camera_mount.FCStd
20.0 x 20.0 x 3.00 mm
