fatooo/PITECH/Assembly_Tiva/lab41/Objects/lab4.htm

# Static Call Graph for image .\Objects\lab4.axf

#<CALLGRAPH># ARM Linker, 5060750: Last Updated: Sat Dec 08 17:15:01 2018

### Maximum Stack Usage = 0 bytes + Unknown(Functions without stacksize, Cycles, Untraceable Function Pointers)

### Call chain for Maximum Stack Depth:

### Functions with no stack information

- Reset_Handler
- ADC1Seq0_Handler
- ADC1Seq1_Handler
- ADC1Seq2_Handler
- ADC1Seq3_Handler
- CAN0_Handler
- CAN1_Handler
- CAN2_Handler
- Comp0_Handler
- Comp1_Handler
- Comp2_Handler
- Ethernet_Handler
- ExtBus_Handler
- FPU_Handler
- Fan0_Handler
- FlashCtl_Handler
- GPIOPortF_Handler
- GPIOPortG_Handler
- GPIOPortH_Handler
- GPIOPortJ_Handler
- GPIOPortK_Handler
- GPIOPortL_Handler
- GPIOPortM_Handler
- GPIOPortN_Handler
- GPIOPortP1_Handler
- GPIOPortP2_Handler
- GPIOPortP3_Handler
- GPIOPortP4_Handler
- GPIOPortP5_Handler
- GPIOPortP6_Handler
- GPIOPortP7_Handler
- GPIOPortP_Handler
- GPIOPortQ1_Handler
- GPIOPortQ2_Handler
- GPIOPortQ3_Handler
- GPIOPortQ4_Handler
- GPIOPortQ5_Handler
- GPIOPortQ6_Handler
- GPIOPortQ7_Handler
- GPIOPortQ_Handler
- GPIOPortR_Handler
- GPIOPortS_Handler
- Hibernate_Handler
- I2C1_Handler
- I2C2_Handler
- I2C3_Handler
- I2C4_Handler
- I2C5_Handler
- I2S0_Handler
- LPC0_Handler
- PECI0_Handler
- PWM0Generator3_Handler
- PWM1Fault_Handler
- PWM1Generator0_Handler
- PWM1Generator1_Handler
- PWM1Generator2_Handler
- PWM1Generator3_Handler
- Quadrature1_Handler
- Quadrature2_Handler
- SSI1_Handler
- SSI2_Handler
- SSI3_Handler
- SysCtl_Handler
- Timer0B_Handler
- Timer1A_Handler
- Timer1B_Handler
- Timer2A_Handler
- Timer2B_Handler
- Timer3A_Handler
- Timer3B_Handler
- Timer4A_Handler
- Timer4B_Handler
- Timer5A_Handler
- Timer5B_Handler
- UART2_Handler
- UART3_Handler
- UART4_Handler
- UART5_Handler
- UART6_Handler
- UART7_Handler
- USB0_Handler
- WideTimer0A_Handler
- WideTimer0B_Handler
- WideTimer1A_Handler
- WideTimer1B_Handler
- WideTimer2A_Handler
- WideTimer2B_Handler
- WideTimer3A_Handler
- WideTimer3B_Handler
- WideTimer4A_Handler
- WideTimer4B_Handler
- WideTimer5A_Handler
- WideTimer5B_Handler
- uDMA_Error
- uDMA_Handler
- OutStr

### Mutually Recursive functions

- __main ⇒ __main
- NMI_Handler ⇒ NMI_Handler
- HardFault_Handler ⇒ HardFault_Handler
- MemManage_Handler ⇒ MemManage_Handler
- BusFault_Handler ⇒ BusFault_Handler
- UsageFault_Handler ⇒ UsageFault_Handler
- SVC_Handler ⇒ SVC_Handler
- DebugMon_Handler ⇒ DebugMon_Handler
- PendSV_Handler ⇒ PendSV_Handler
- SysTick_Handler ⇒ SysTick_Handler
- ADC1Seq0_Handler ⇒ ADC1Seq0_Handler

### Function Pointers

- ADC0Seq0_Handler from startup.o(RESET) referenced from startup.o(RESET)
- ADC0Seq1_Handler from startup.o(RESET) referenced from startup.o(RESET)
- ADC0Seq2_Handler from startup.o(RESET) referenced from startup.o(RESET)
- ADC0Seq3_Handler from startup.o(RESET) referenced from startup.o(RESET)
- ADC1Seq0_Handler from startup.o(RESET) referenced from startup.o(RESET)
- ADC1Seq1_Handler from startup.o(RESET) referenced from startup.o(RESET)
- ADC1Seq2_Handler from startup.o(RESET) referenced from startup.o(RESET)
- ADC1Seq3_Handler from startup.o(RESET) referenced from startup.o(RESET)
- BusFault_Handler from startup.o(RESET) referenced from startup.o(RESET)
- CAN0_Handler from startup.o(RESET) referenced from startup.o(RESET)
- CAN1_Handler from startup.o(RESET) referenced from startup.o(RESET)
- CAN2_Handler from startup.o(RESET) referenced from startup.o(RESET)
- Comp0_Handler from startup.o(RESET) referenced from startup.o(RESET)
- Comp1_Handler from startup.o(RESET) referenced from startup.o(RESET)
- Comp2_Handler from startup.o(RESET) referenced from startup.o(RESET)
- DebugMon_Handler from startup.o(RESET) referenced from startup.o(RESET)
- Ethernet_Handler from startup.o(RESET) referenced from startup.o(RESET)
- ExtBus_Handler from startup.o(RESET) referenced from startup.o(RESET)
- FPU_Handler from startup.o(RESET) referenced from startup.o(RESET)
- Fan0_Handler from startup.o(RESET) referenced from startup.o(RESET)
- FlashCtl_Handler from startup.o(RESET) referenced from startup.o(RESET)
- GPIOPortA_Handler from startup.o(RESET) referenced from startup.o(RESET)
- GPIOPortB_Handler from startup.o(RESET) referenced from startup.o(RESET)
- GPIOPortC_Handler from startup.o(RESET) referenced from startup.o(RESET)
- GPIOPortD_Handler from startup.o(RESET) referenced from startup.o(RESET)
- GPIOPortE_Handler from startup.o(RESET) referenced from startup.o(RESET)
- GPIOPortF_Handler from startup.o(RESET) referenced from startup.o(RESET)
- GPIOPortG_Handler from startup.o(RESET) referenced from startup.o(RESET)
- GPIOPortH_Handler from startup.o(RESET) referenced from startup.o(RESET)
- GPIOPortJ_Handler from startup.o(RESET) referenced from startup.o(RESET)
- GPIOPortK_Handler from startup.o(RESET) referenced from startup.o(RESET)
- GPIOPortL_Handler from startup.o(RESET) referenced from startup.o(RESET)
- GPIOPortM_Handler from startup.o(RESET) referenced from startup.o(RESET)
- GPIOPortN_Handler from startup.o(RESET) referenced from startup.o(RESET)
- GPIOPortP1_Handler from startup.o(RESET) referenced from startup.o(RESET)
- GPIOPortP2_Handler from startup.o(RESET) referenced from startup.o(RESET)
- GPIOPortP3_Handler from startup.o(RESET) referenced from startup.o(RESET)
- GPIOPortP4_Handler from startup.o(RESET) referenced from startup.o(RESET)
- GPIOPortP5_Handler from startup.o(RESET) referenced from startup.o(RESET)
- GPIOPortP6_Handler from startup.o(RESET) referenced from startup.o(RESET)
- GPIOPortP7_Handler from startup.o(RESET) referenced from startup.o(RESET)
- GPIOPortP_Handler from startup.o(RESET) referenced from startup.o(RESET)
- GPIOPortQ1_Handler from startup.o(RESET) referenced from startup.o(RESET)
- GPIOPortQ2_Handler from startup.o(RESET) referenced from startup.o(RESET)
- GPIOPortQ3_Handler from startup.o(RESET) referenced from startup.o(RESET)
- GPIOPortQ4_Handler from startup.o(RESET) referenced from startup.o(RESET)
- GPIOPortQ5_Handler from startup.o(RESET) referenced from startup.o(RESET)
- GPIOPortQ6_Handler from startup.o(RESET) referenced from startup.o(RESET)
- GPIOPortQ7_Handler from startup.o(RESET) referenced from startup.o(RESET)
- GPIOPortQ_Handler from startup.o(RESET) referenced from startup.o(RESET)
- GPIOPortR_Handler from startup.o(RESET) referenced from startup.o(RESET)
- GPIOPortS_Handler from startup.o(RESET) referenced from startup.o(RESET)
- HardFault_Handler from startup.o(RESET) referenced from startup.o(RESET)
- Hibernate_Handler from startup.o(RESET) referenced from startup.o(RESET)
- I2C0_Handler from startup.o(RESET) referenced from startup.o(RESET)
- I2C1_Handler from startup.o(RESET) referenced from startup.o(RESET)
- I2C2_Handler from startup.o(RESET) referenced from startup.o(RESET)
- I2C3_Handler from startup.o(RESET) referenced from startup.o(RESET)
- I2C4_Handler from startup.o(RESET) referenced from startup.o(RESET)
- I2C5_Handler from startup.o(RESET) referenced from startup.o(RESET)
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
- WideTimer4A_Handler from startup.o(RESET) referenced from startup.o(RESET)
- WideTimer4B_Handler from startup.o(RESET) referenced from startup.o(RESET)
- WideTimer5A_Handler from startup.o(RESET) referenced from startup.o(RESET)
- WideTimer5B_Handler from startup.o(RESET) referenced from startup.o(RESET)
- uDMA_Error from startup.o(RESET) referenced from startup.o(RESET)
- uDMA_Handler from startup.o(RESET) referenced from startup.o(RESET)

### Global Symbols

Reset_Handler (Thumb, 0 bytes, Stack size unknown bytes, startup.o(RESET))

[Calls]

- >> __main

NMI_Handler (Thumb, 2 bytes, Stack size 0 bytes, startup.o(RESET))

[Calls]

- >> NMI_Handler

[Called By]

- >> NMI_Handler

[Address Reference Count : 1]

- startup.o(RESET)

HardFault_Handler (Thumb, 2 bytes, Stack size 0 bytes, startup.o(RESET))

[Calls]

- >> HardFault_Handler

[Called By]

- >> HardFault_Handler

[Address Reference Count : 1]

- startup.o(RESET)

MemManage_Handler (Thumb, 2 bytes, Stack size 0 bytes, startup.o(RESET))

[Calls]

- >> MemManage_Handler

[Called By]

- >> MemManage_Handler

[Address Reference Count : 1]

- startup.o(RESET)

BusFault_Handler (Thumb, 2 bytes, Stack size 0 bytes, startup.o(RESET))

[Calls]

- >> BusFault_Handler

[Called By]

- >> BusFault_Handler

[Address Reference Count : 1]

- startup.o(RESET)

UsageFault_Handler (Thumb, 2 bytes, Stack size 0 bytes, startup.o(RESET))

[Calls]

- >> UsageFault_Handler

[Called By]

- >> UsageFault_Handler

[Address Reference Count : 1]

- startup.o(RESET)

SVC_Handler (Thumb, 2 bytes, Stack size 0 bytes, startup.o(RESET))

[Calls]

- >> SVC_Handler

[Called By]

- >> SVC_Handler

[Address Reference Count : 1]

- startup.o(RESET)

DebugMon_Handler (Thumb, 2 bytes, Stack size 0 bytes, startup.o(RESET))

[Calls]

- >> DebugMon_Handler

[Called By]

- >> DebugMon_Handler

[Address Reference Count : 1]

- startup.o(RESET)

PendSV_Handler (Thumb, 2 bytes, Stack size 0 bytes, startup.o(RESET))

[Calls]

- >> PendSV_Handler

[Called By]

- >> PendSV_Handler

[Address Reference Count : 1]

- startup.o(RESET)

SysTick_Handler (Thumb, 2 bytes, Stack size 0 bytes, startup.o(RESET))

[Calls]

- >> SysTick_Handler

[Called By]

- >> SysTick_Handler

[Address Reference Count : 1]

- startup.o(RESET)

ADC0Seq0_Handler (Thumb, 0 bytes, Stack size 0 bytes, startup.o(RESET))

[Calls]

- >> My_Timer0A_Handler

[Address Reference Count : 1]

- startup.o(RESET)

ADC0Seq1_Handler (Thumb, 0 bytes, Stack size 0 bytes, startup.o(RESET))
[Address Reference Count : 1]

- startup.o(RESET)

ADC0Seq2_Handler (Thumb, 0 bytes, Stack size 0 bytes, startup.o(RESET))
[Address Reference Count : 1]

- startup.o(RESET)

ADC0Seq3_Handler (Thumb, 0 bytes, Stack size 0 bytes, startup.o(RESET))
[Address Reference Count : 1]

- startup.o(RESET)

GPIOPortA_Handler (Thumb, 0 bytes, Stack size 0 bytes, startup.o(RESET))
[Address Reference Count : 1]

- startup.o(RESET)

GPIOPortB_Handler (Thumb, 0 bytes, Stack size 0 bytes, startup.o(RESET))
[Address Reference Count : 1]

- startup.o(RESET)

GPIOPortC_Handler (Thumb, 0 bytes, Stack size 0 bytes, startup.o(RESET))
[Address Reference Count : 1]

- startup.o(RESET)

GPIOPortD_Handler (Thumb, 0 bytes, Stack size 0 bytes, startup.o(RESET))
[Address Reference Count : 1]

- startup.o(RESET)

GPIOPortE_Handler (Thumb, 0 bytes, Stack size 0 bytes, startup.o(RESET))
[Address Reference Count : 1]

- startup.o(RESET)

I2C0_Handler (Thumb, 0 bytes, Stack size 0 bytes, startup.o(RESET))
[Address Reference Count : 1]

- startup.o(RESET)

PWM0Fault_Handler (Thumb, 0 bytes, Stack size 0 bytes, startup.o(RESET))
[Address Reference Count : 1]

- startup.o(RESET)

PWM0Generator0_Handler (Thumb, 0 bytes, Stack size 0 bytes, startup.o(RESET))
[Address Reference Count : 1]

- startup.o(RESET)

PWM0Generator1_Handler (Thumb, 0 bytes, Stack size 0 bytes, startup.o(RESET))
[Address Reference Count : 1]

- startup.o(RESET)

PWM0Generator2_Handler (Thumb, 0 bytes, Stack size 0 bytes, startup.o(RESET))
[Address Reference Count : 1]

- startup.o(RESET)

Quadrature0_Handler (Thumb, 0 bytes, Stack size 0 bytes, startup.o(RESET))
[Address Reference Count : 1]

- startup.o(RESET)

SSI0_Handler (Thumb, 0 bytes, Stack size 0 bytes, startup.o(RESET))
[Address Reference Count : 1]

- startup.o(RESET)

Timer0A_Handler (Thumb, 0 bytes, Stack size 0 bytes, startup.o(RESET))
[Address Reference Count : 1]

- startup.o(RESET)

UART0_Handler (Thumb, 0 bytes, Stack size 0 bytes, startup.o(RESET))
[Address Reference Count : 1]

- startup.o(RESET)

UART1_Handler (Thumb, 0 bytes, Stack size 0 bytes, startup.o(RESET))
[Address Reference Count : 1]

- startup.o(RESET)

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

- startup.o(RESET)

UART6_Handler (Thumb, 0 bytes, Stack size unknown bytes, startup.o(RESET))
[Address Reference Count : 1]

- startup.o(RESET)

UART7_Handler (Thumb, 0 bytes, Stack size unknown bytes, startup.o(RESET))
[Address Reference Count : 1]

- startup.o(RESET)

USB0_Handler (Thumb, 0 bytes, Stack size unknown bytes, startup.o(RESET))
[Address Reference Count : 1]

- startup.o(RESET)

WideTimer0A_Handler (Thumb, 0 bytes, Stack size unknown bytes, startup.o(RESET))
[Address Reference Count : 1]

- startup.o(RESET)

WideTimer0B_Handler (Thumb, 0 bytes, Stack size unknown bytes, startup.o(RESET))
[Address Reference Count : 1]

- startup.o(RESET)

WideTimer1A_Handler (Thumb, 0 bytes, Stack size unknown bytes, startup.o(RESET))
[Address Reference Count : 1]

- startup.o(RESET)

WideTimer1B_Handler (Thumb, 0 bytes, Stack size unknown bytes, startup.o(RESET))
[Address Reference Count : 1]

- startup.o(RESET)

WideTimer2A_Handler (Thumb, 0 bytes, Stack size unknown bytes, startup.o(RESET))
[Address Reference Count : 1]

- startup.o(RESET)

WideTimer2B_Handler (Thumb, 0 bytes, Stack size unknown bytes, startup.o(RESET))
[Address Reference Count : 1]

- startup.o(RESET)

WideTimer3A_Handler (Thumb, 0 bytes, Stack size unknown bytes, startup.o(RESET))
[Address Reference Count : 1]

- startup.o(RESET)

WideTimer3B_Handler (Thumb, 0 bytes, Stack size unknown bytes, startup.o(RESET))
[Address Reference Count : 1]

- startup.o(RESET)

WideTimer4A_Handler (Thumb, 0 bytes, Stack size unknown bytes, startup.o(RESET))
[Address Reference Count : 1]

- startup.o(RESET)

WideTimer4B_Handler (Thumb, 0 bytes, Stack size unknown bytes, startup.o(RESET))
[Address Reference Count : 1]

- startup.o(RESET)

WideTimer5A_Handler (Thumb, 0 bytes, Stack size unknown bytes, startup.o(RESET))
[Address Reference Count : 1]

- startup.o(RESET)

WideTimer5B_Handler (Thumb, 0 bytes, Stack size unknown bytes, startup.o(RESET))
[Address Reference Count : 1]

- startup.o(RESET)

uDMA_Error (Thumb, 0 bytes, Stack size unknown bytes, startup.o(RESET))
[Address Reference Count : 1]

- startup.o(RESET)

uDMA_Handler (Thumb, 0 bytes, Stack size unknown bytes, startup.o(RESET))
[Address Reference Count : 1]

- startup.o(RESET)

OutStr (Thumb, 0 bytes, Stack size unknown bytes, outstr.o(.text))

[Called By]

- >> __main

__use_two_region_memory (Thumb, 2 bytes, Stack size 0 bytes, heapauxi.o(.text), UNUSED)

__rt_heap_escrow$2region (Thumb, 2 bytes, Stack size 0 bytes, heapauxi.o(.text), UNUSED)

__rt_heap_expand$2region (Thumb, 2 bytes, Stack size 0 bytes, heapauxi.o(.text), UNUSED)

PULSE_INPUT_INIT (Thumb, 136 bytes, Stack size 0 bytes, pulse_input_2.o(main))

[Called By]

- >> __main

__main (Thumb, 170 bytes, Stack size 0 bytes, week_demo_2.o(main))

[Calls]

- >> ledingen
- >> CONVRT
- >> __main
- >> PULSE_INPUT_INIT
- >> PULSE_INIT
- >> OutStr

[Called By]

- >> __main
- >> Reset_Handler

My_Timer0A_Handler (Thumb, 58 bytes, Stack size 0 bytes, pulse.o(routines))

[Called By]

- >> ADC0Seq0_Handler

PULSE_INIT (Thumb, 162 bytes, Stack size 0 bytes, pulse.o(routines))

[Called By]

- >> __main

CONVRT (Thumb, 62 bytes, Stack size 0 bytes, convrt.o(routines))

[Called By]

- >> __main

ledingen (Thumb, 80 bytes, Stack size 0 bytes, ledingen.o(sdata))

[Called By]

- >> __main

### Local Symbols

### Undefined Global Symbols
