fatooo/PITECH/SOFTRESETDENEME/tx_final/tx_final.ino

#include  <SPI.h> 
#include "nRF24L01.h"
#include "RF24.h"     //Modül ile ilgili kütüphaneleri ekliyoruz
#include <avr/wdt.h>
RF24 verici(9,10);     //kütüphane tarafından kullanılacak pinleri tanımlıyoruz (CE,CSN)
const uint64_t kanal = 0xE8E8F0F0E1LL; //kanalı tanımlıyoruz  
int joystick_x_pin = A0;
 int joystick_y_pin = A1;
 int joystick_switch_pin = A2;
 int joystick_x=0;
 int joystick_y=0;
 int joystick_switch = 0;
 int message[1] ; 
void setup(void)
{
 Serial.begin(9600);
 watchdogSetup();
 verici.begin();       //nrf yi başlatıyoruz
 verici.openWritingPipe(kanal);  //kanal id sı tanımlanıyor
}
 void watchdogSetup(void)
{
cli();  // disable all interrupts
wdt_reset(); // reset the WDT timer
/*
WDTCSR configuration:
WDIE = 1: Interrupt Enable
WDE = 1 :Reset Enable
WDP3 = 0 :For 1000ms Time-out
WDP2 = 1 :For 1000ms Time-out
WDP1 = 1 :For 1000ms Time-out
WDP0 = 0 :For 1000ms Time-out
*/
// Enter Watchdog Configuration mode:
WDTCSR |= (1<<WDCE) | (1<<WDE);
// Set Watchdog settings:
WDTCSR = (1<<WDIE) | (1<<WDE) | (0<<WDP3) | (1<<WDP2) | (1<<WDP1) | (0<<WDP0);
sei();
}


void loop(void)
{  
     //Reading commands from joystick
     joystick_x = analogRead(joystick_x_pin)-512;
     joystick_y = analogRead(joystick_y_pin)-512;
     joystick_switch = analogRead(joystick_switch_pin);
     if(joystick_y>400){
        
            message[0]=B00000010;
           // Serial.println(joystick_x);      
          }
        else if (joystick_y<-400){      
            message[0]=B00000001;     
             // Serial.println(joystick_x);
              }
       else if (joystick_x>400){
                message[0] = B00001000;
               //Serial.println(joystick_y);      
              }
        else if (joystick_x<-400){
                message[0]=B00000100;
                //Serial.println(joystick_y);
               }
        else if  (joystick_switch <50) {
               message[0]=B00010000;
                }
           else if (joystick_y<450 && joystick_y>100) {
                message[0]=32; 
          
          }
          else if (joystick_y<-100 && joystick_y>-450) {
                message[0]=64; 
          
          }

           else if (joystick_x>100 && joystick_x<450){
                message[0] = 9;
                    
              }
        else if (joystick_x<-100 && joystick_x>-450){
                message[0]=5;
                //Serial.println(joystick_y);
               }        
        else  {
               message[0]=B00000000;
              }  
 wdt_reset();
 verici.write(message, 1);   //mesaj değişkeni yollanıyor 
 Serial.println(message[0]);
 
 }
