fatooo/PITECH/Arduino Denemeleri/Frequency_Counter/Frequency_Counter.ino

//#include <LiquidCrystal.h>

//LiquidCrystal lcd(2, 3, 4, 5, 6, 7);

int Htime;              //integer for storing high time
int Ltime;                //integer for storing low time
float Ttime;            // integer for storing total time of a cycle
float frequency;        //storing frequency

void setup()
{
    pinMode(41,INPUT); //square wave input from Schmitt Trigger
    Serial.begin(9600);
    //lcd.begin(16, 2);
}
void loop()
{
//    lcd.clear();
//    lcd.setCursor(0,0);
//    lcd.print("Frequency of signal");

    Htime=pulseIn(41,HIGH);      //read high time
    Ltime=pulseIn(41,LOW);        //read low time
    
    Ttime = Htime+Ltime;

    frequency=1000000/Ttime;    //getting frequency with Ttime is in Micro seconds
//    lcd.setCursor(0,1);
//    lcd.print(frequency);
//    lcd.print(" Hz");
    Serial.println(frequency);
    delay(500);
}
