fatooo/PITECH/raspberrypidenemeleri/FM_TXX/wave_reader.cpp

/*
    fm_transmitter - use Raspberry Pi as FM transmitter

    Copyright (c) 2015, Marcin Kondej
    All rights reserved.

    See https://github.com/markondej/fm_transmitter

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
    1. Redistributions of source code must retain the above copyright notice, this list
    of conditions and the following disclaimer.

    2. Redistributions in binary form must reproduce the above copyright notice, this
    list of conditions and the following disclaimer in the documentation and/or other
    materials provided with the distribution.

    3. Neither the name of the copyright holder nor the names of its contributors may be
    used to endorse or promote products derived from this software without specific
    prior written permission.

    THIS SOFTWARE IS PROVIDED BY THE COPYRIGHT HOLDERS AND CONTRIBUTORS "AS IS" AND ANY
    EXPRESS OR IMPLIED WARRANTIES, INCLUDING, BUT NOT LIMITED TO, THE IMPLIED WARRANTIES
    OF MERCHANTABILITY AND FITNESS FOR A PARTICULAR PURPOSE ARE DISCLAIMED. IN NO EVENT
    SHALL THE COPYRIGHT HOLDER OR CONTRIBUTORS BE LIABLE FOR ANY DIRECT, INDIRECT,
    INCIDENTAL, SPECIAL, EXEMPLARY, OR CONSEQUENTIAL DAMAGES (INCLUDING, BUT NOT LIMITED
    TO, PROCUREMENT OF SUBSTITUTE GOODS OR SERVICES; LOSS OF USE, DATA, OR PROFITS; OR
    BUSINESS INTERRUPTION) HOWEVER CAUSED AND ON ANY THEORY OF LIABILITY, WHETHER IN
    CONTRACT, STRICT LIABILITY, OR TORT (INCLUDING NEGLIGENCE OR OTHERWISE) ARISING IN ANY
    WAY OUT OF THE USE OF THIS SOFTWARE, EVEN IF ADVISED OF THE POSSIBILITY OF SUCH DAMAGE.
*/

#include "wave_reader.h"
#include "error_reporter.h"
#include <sstream>
#include <string.h>
#include "gpio.h"

using std::ostringstream;
using std::exception;

WaveReader::WaveReader(string filename) :
    filename(filename)
{
    char* headerData;
    vector<char>* data;
    unsigned bytesToRead, headerOffset;
    ostringstream oss;

    ifs.open(filename.c_str(), ifstream::binary);
    headerData = (char*)((void*)&header);

    if (!ifs.is_open()) {
        oss << "Cannot open " << filename << ", file does not exist";
        throw ErrorReporter(oss.str());
    }

    ifs.seekg(0, ifs.end);
    fileSize = ifs.tellg();
    ifs.seekg(0, ifs.beg);

    try {
        bytesToRead = sizeof(PCMWaveHeader::chunkID) + sizeof(PCMWaveHeader::chunkSize) + sizeof(PCMWaveHeader::format);
        data = readData(bytesToRead, true);
        memcpy(headerData, &(*data)[0], bytesToRead);
        headerOffset = bytesToRead;
        delete data;

        if ((string(header.chunkID, 4) != string("RIFF")) || (string(header.format, 4) != string("WAVE"))) {
            oss << "Error while opening " << filename << ", WAVE file expected";
            throw ErrorReporter(oss.str());
        }

        bytesToRead = sizeof(PCMWaveHeader::subchunk1ID) + sizeof(PCMWaveHeader::subchunk1Size);
        data = readData(bytesToRead, true);
        memcpy(&headerData[headerOffset], &(*data)[0], bytesToRead);
        headerOffset += bytesToRead;
        delete data;

        unsigned subchunk1MinSize = sizeof(PCMWaveHeader) - headerOffset - sizeof(PCMWaveHeader::subchunk2ID) - sizeof(PCMWaveHeader::subchunk2Size);
        if ((string(header.subchunk1ID, 4) != string("fmt ")) || (header.subchunk1Size < subchunk1MinSize)) {
            oss << "Error while opening " << filename << ", data corrupted";
            throw ErrorReporter(oss.str());
        }

        data = readData(header.subchunk1Size, true);
        memcpy(&headerData[headerOffset], &(*data)[0], subchunk1MinSize);
        headerOffset += subchunk1MinSize;
        delete data;

        if ((header.audioFormat != WAVE_FORMAT_PCM) ||
            (header.byteRate != (header.bitsPerSample >> 3) * header.channels * header.sampleRate) ||
            (header.blockAlign != (header.bitsPerSample >> 3) * header.channels) ||
            (((header.bitsPerSample >> 3) != 1) && ((header.bitsPerSample >> 3) != 2))) {
            oss << "Error while opening " << filename << ", unsupported WAVE format";
            throw ErrorReporter(oss.str());
        }

        bytesToRead = sizeof(PCMWaveHeader::subchunk2ID) + sizeof(PCMWaveHeader::subchunk2Size);
        data = readData(bytesToRead, true);
        memcpy(&headerData[headerOffset], &(*data)[0], bytesToRead);
        headerOffset += bytesToRead;
        delete data;

        if ((string(header.subchunk2ID, 4) != string("data")) || (header.subchunk2Size + ifs.tellg() < fileSize)) {
            oss << "Error while opening " << filename << ", data corrupted";
            throw ErrorReporter(oss.str());
        }
    } catch (ErrorReporter &error) {
        ifs.close();
        throw error;
    }

    dataOffset = ifs.tellg();
}

WaveReader::~WaveReader()
{
    ifs.close();
}

vector<char>* WaveReader::readData(unsigned bytesToRead, bool closeFileOnException)
{
    if (fileSize < (unsigned)ifs.tellg() + bytesToRead) {
        ostringstream oss;
        oss << "Error while reading " << filename << ", data corrupted";
        if (closeFileOnException) ifs.close();
        throw ErrorReporter(oss.str());
    }

    vector<char>* data = new vector<char>();
    data->resize(bytesToRead);
    ifs.read(&(*data)[0], bytesToRead);
    return data;
}

vector<float>* WaveReader::getFrames(unsigned frameCount, unsigned frameOffset) {
    unsigned bytesToRead, bytesLeft, bytesPerFrame, offset;
    vector<float>* frames = new vector<float>();
    vector<char>* data;

    bytesPerFrame = (header.bitsPerSample >> 3) * header.channels;
    bytesToRead = frameCount * bytesPerFrame;
    bytesLeft = header.subchunk2Size - frameOffset * bytesPerFrame;

    if (bytesToRead > bytesLeft) {
        bytesToRead = bytesLeft - bytesLeft % bytesPerFrame;
        frameCount = bytesToRead / bytesPerFrame;
    }

    ifs.seekg(dataOffset + frameOffset * bytesPerFrame);

    try {
        data = readData(bytesToRead, false);
    } catch (ErrorReporter &error) {
        delete frames;
        throw error;
    }
    for (unsigned i = 0; i < frameCount; i++) {
        offset = bytesPerFrame * i;
        if (header.channels != 1) {
            if (header.bitsPerSample != 8) {
                frames->push_back(((int)(signed char)(*data)[offset + 1] + (int)(signed char)(*data)[offset + 3]) / (float)0x100);
            } else {
                frames->push_back(((int)(*data)[offset] + (int)(*data)[offset + 1]) / (float)0x100 - 1.0f);
            }
        } else {
            if (header.bitsPerSample != 8) {
                frames->push_back((signed char)(*data)[offset + 1] / (float)0x80);
            } else {
                frames->push_back((*data)[offset] / (float)0x80 - 1.0f);
            }
        }
    }

    delete data;

    return frames;
}

bool WaveReader::isEnd(unsigned frameOffset)
{
    return header.subchunk2Size <= frameOffset * (header.bitsPerSample >> 3) * header.channels;
}

AudioFormat* WaveReader::getFormat()
{
    AudioFormat* format = new AudioFormat;
    format->channels = header.channels;
    format->sampleRate = header.sampleRate;
    format->bitsPerSample = header.bitsPerSample;
    return format;
}
