fatooo/PITECH/(commit log)

2018-11-05 Update raspberrypidenemeleri/color detect.py
2018-11-20 s2k denemesi
    [sin2k.xlsx]
2018-12-11 freq counter
    [Freqeuncy_Counter_Data.xlsx]
2018-12-13 fato added
    [Freqeuncy_Counter_Data.xlsx]
2018-12-20 yeni arduino kodu
    denenmedi
2018-12-23 Create Power_Supply_subsystem.docx
    Power_Supply_subsystem
2018-12-23 a
    power_supply_subsystem
2019-04-07 motor kodu
    [camera_mount.FCStd]
